ArcBotics/Sparki/Lessons/SparkiDuino/mazeSolving/Sparki.Poster.Maze1.90x70.png

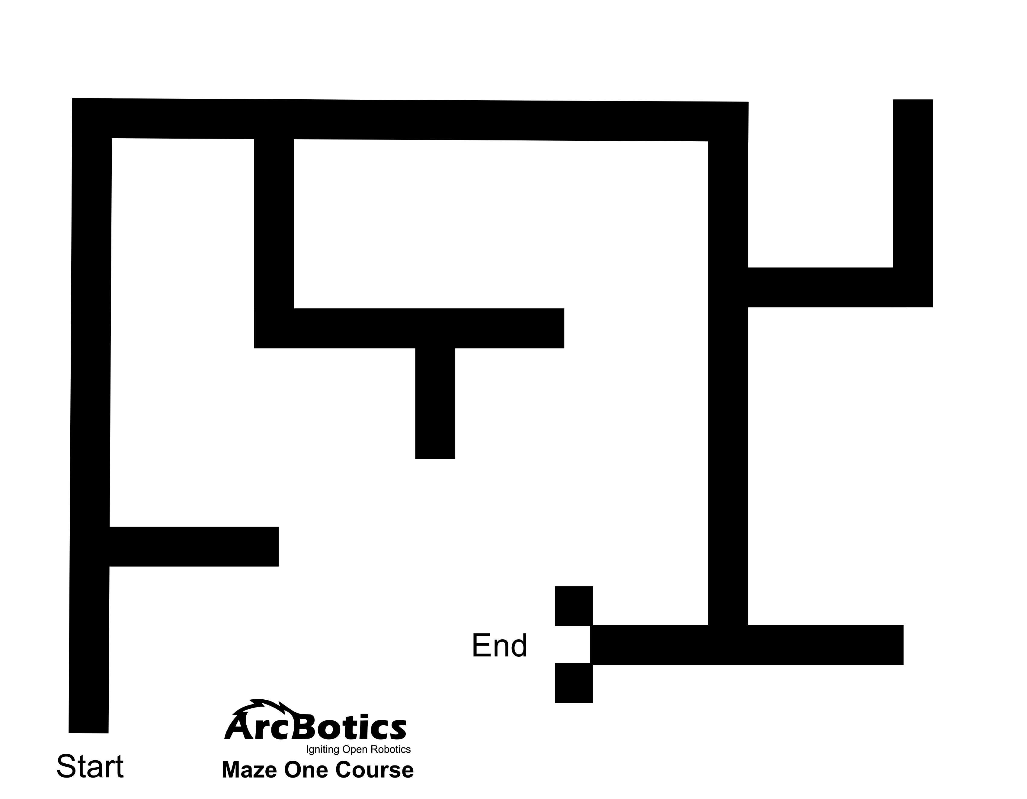
Lessons/SparkiDuino/mazeSolving/Sparki.Poster.Maze1.90x70.png
