ArcBotics/Sparki/3D Model/Full Robot.SLDASM

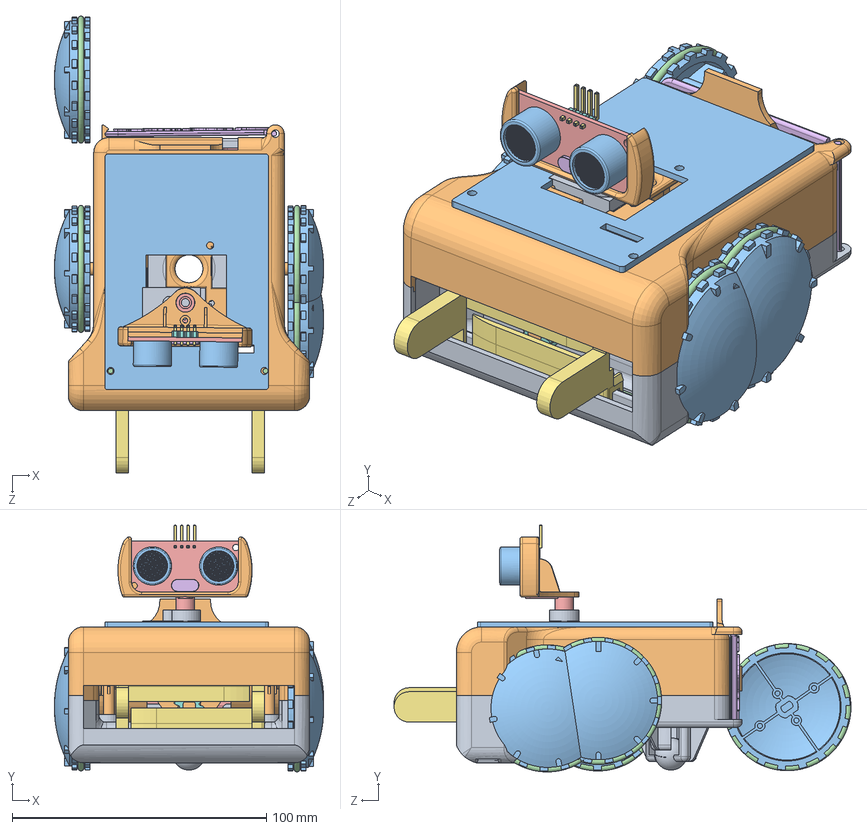
[picture p2: CAD file, 2013-09-03]
3D Model/Full Robot.SLDASM
106.0 x 97.1 x 179.8 mm
Bottom
28BYJ48 Stepper Motor x 3
Wheel x 4
ORing x 4
2xAA Battery Holder x 2
AA Battery x 4
Hand x 2
Gear
0.5in Ball Bearing
Head
Metal_Cone x 2
Grid x 2
HC-SR04_Circuit Board
Crystal
HeaderPinRightAngle x 4
HeaderBody x 4
Servo
Top
Board
Sensor Board
Servo Arm Short
Door
