ArcBotics/Sparki/3D Model/HC-SR04/Sense Cone.SLDASM

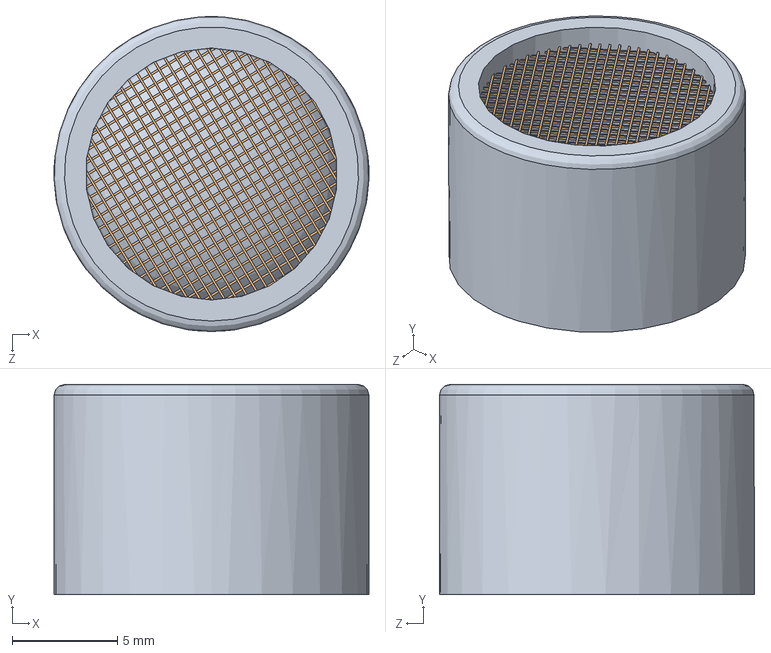
[picture p3: CAD file, 2013-05-01]
3D Model/HC-SR04/Sense Cone.SLDASM
15.0 x 10.0 x 15.0 mm
Metal_Cone
Grid
