ArcBotics/Sparki/3D Model/Injection Molded Plastic/Wheel/Wheel with Ring.SLDASM

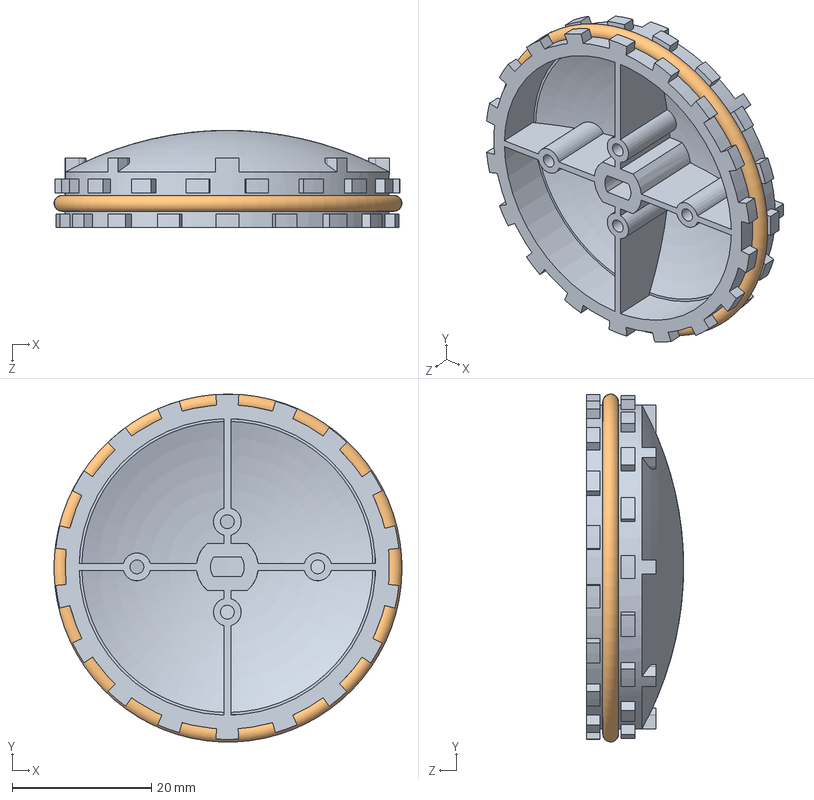
[picture p4: CAD file, 2013-09-03]
3D Model/Injection Molded Plastic/Wheel/Wheel with Ring.SLDASM
50.0 x 50.0 x 14.0 mm
Wheel
ORing
