ArcBotics/Sparki/3D Model/Battery Pack/4xAA Battery Holder.SLDASM

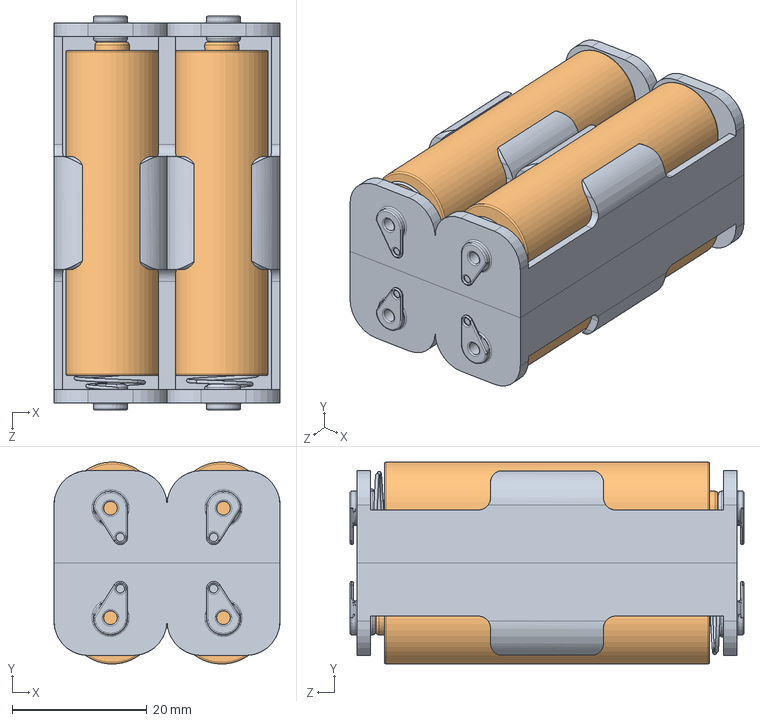
[picture p5: CAD file, 2013-05-01]
3D Model/Battery Pack/4xAA Battery Holder.SLDASM
33.5 x 29.9 x 58.4 mm
2xAA Battery Holder x 2
AA Battery x 4
