ArcBotics/Sparki/3D Model/HC-SR04/HeaderPins_4x1.SLDASM

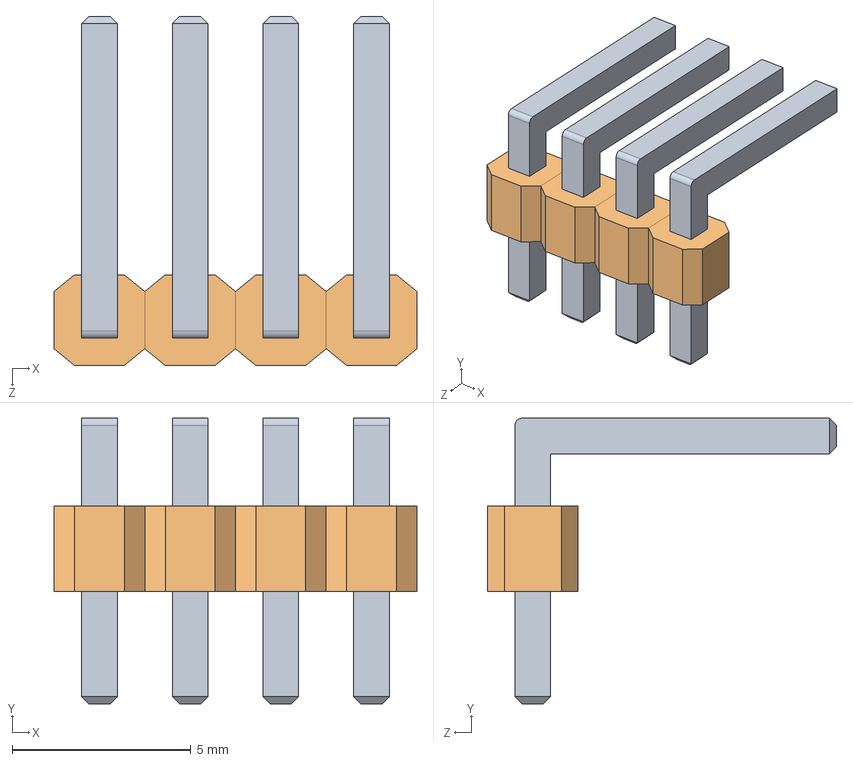
[picture p6: CAD file, 2013-05-01]
3D Model/HC-SR04/HeaderPins_4x1.SLDASM
10.2 x 8.00 x 9.77 mm
HeaderPinRightAngle x 4
HeaderBody x 4
