ArcBotics/Sparki/3D Model/HC-SR04/HC-SR04.SLDASM

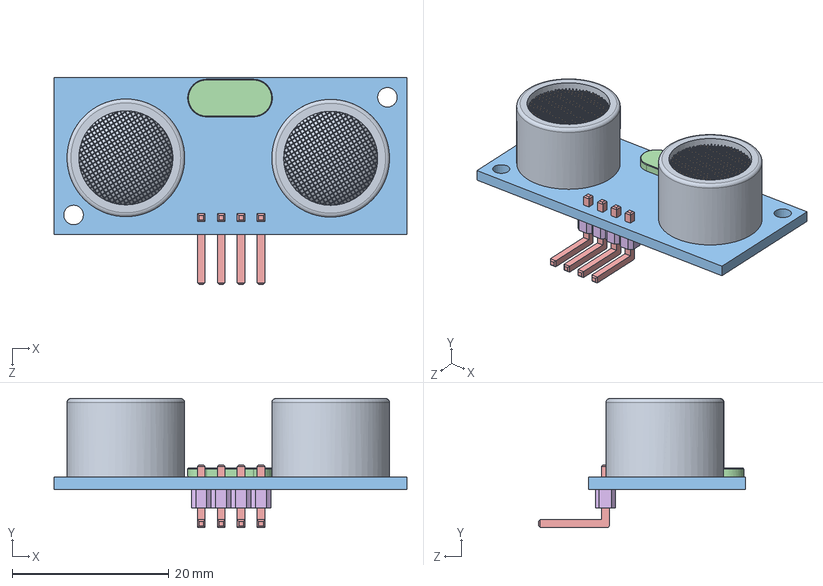
[picture p7: CAD file, 2013-05-01]
3D Model/HC-SR04/HC-SR04.SLDASM
45.0 x 16.5 x 26.3 mm
Metal_Cone x 2
Grid x 2
HC-SR04_Circuit Board
Crystal
HeaderPinRightAngle x 4
HeaderBody x 4
