ArcBotics/Sparki/3D Model/Battery Pack/AA Battery.SLDPRT

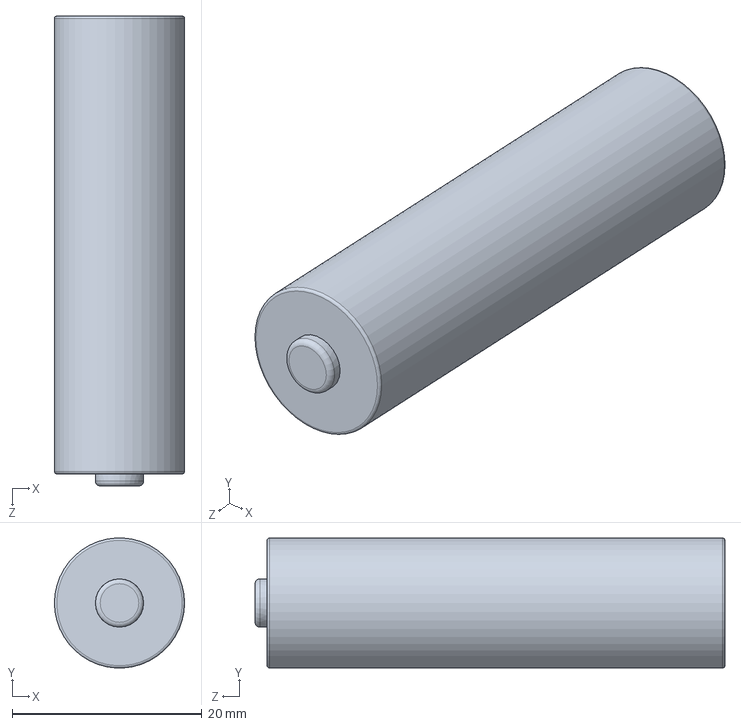
[picture p8: CAD file, 2013-05-01]
3D Model/Battery Pack/AA Battery.SLDPRT
13.7 x 13.7 x 49.5 mm
