ArcBotics/Sparki/3D Model/Injection Molded Plastic/Head.SLDPRT

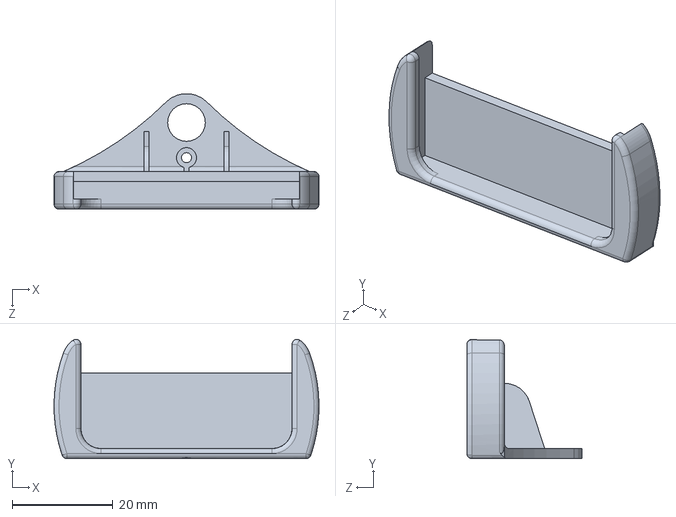
[picture p9: CAD file, 2013-09-03]
3D Model/Injection Molded Plastic/Head.SLDPRT
52.7 x 23.7 x 23.0 mm
