ArcBotics/Sparki/3D Model/Injection Molded Plastic/STEP/Gear.STEP

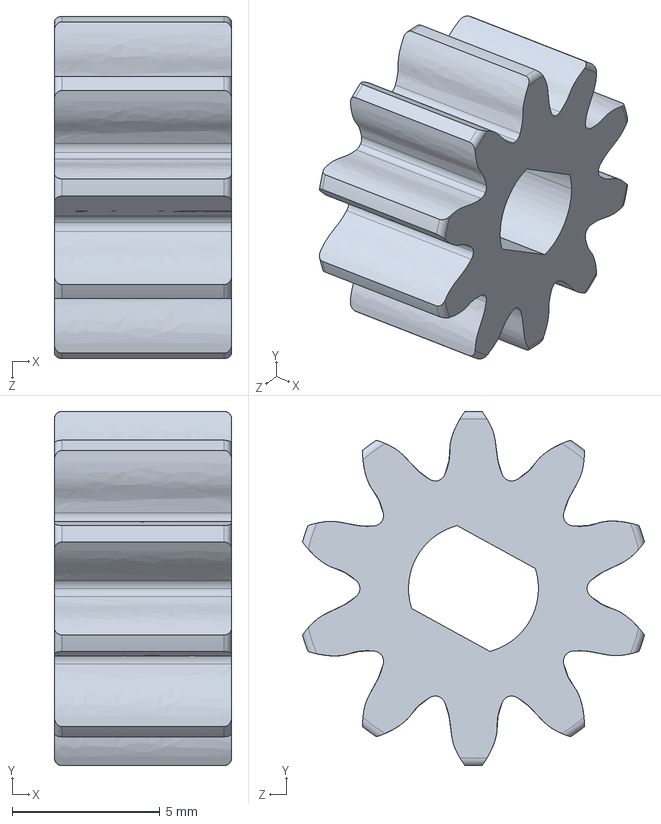
[picture p10: CAD file, 2013-09-03]
3D Model/Injection Molded Plastic/STEP/Gear.STEP
6.00 x 12.0 x 11.6 mm
