ArcBotics/Sparki/3D Model/Servo/Servo.SLDPRT

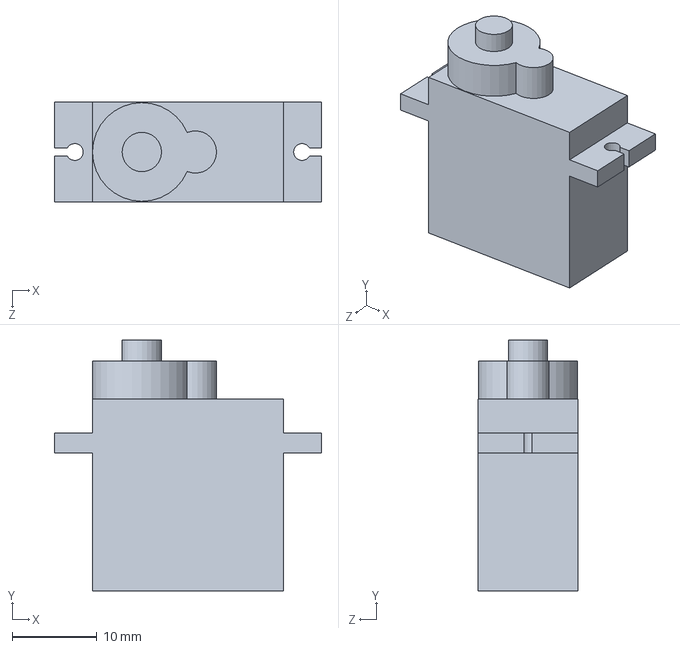
[picture p11: CAD file, 2013-05-01]
3D Model/Servo/Servo.SLDPRT
31.6 x 29.7 x 11.8 mm
