ArcBotics/Sparki/3D Model/Battery Pack/2xAA Battery Holder.SLDPRT

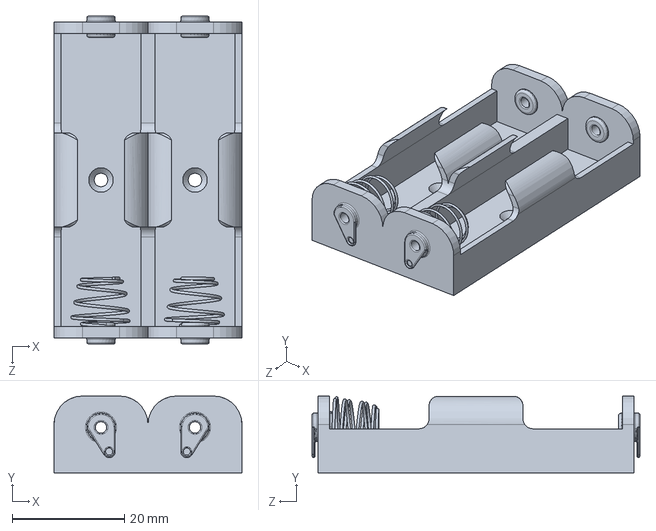
[picture p12: CAD file, 2013-05-01]
3D Model/Battery Pack/2xAA Battery Holder.SLDPRT
33.5 x 13.7 x 58.4 mm
