ArcBotics/Sparki/3D Model/HC-SR04/HeaderBody.SLDPRT

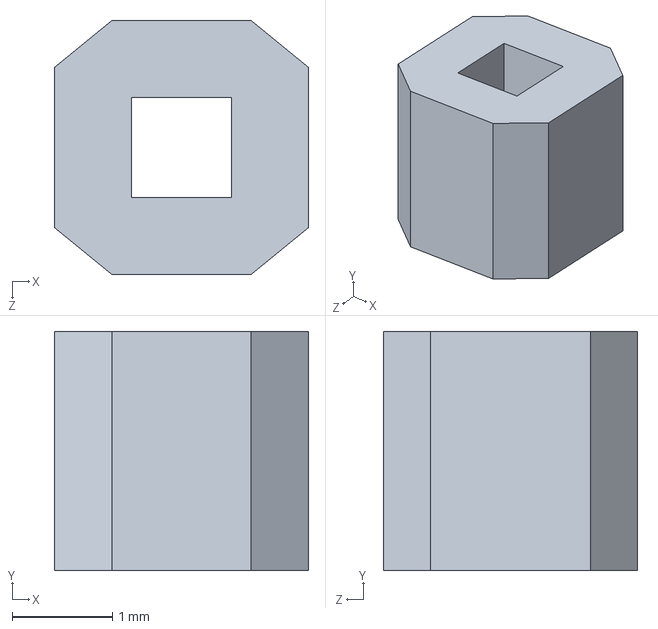
[picture p13: CAD file, 2013-05-01]
3D Model/HC-SR04/HeaderBody.SLDPRT
2.54 x 2.39 x 2.54 mm
