ArcBotics/Sparki/3D Model/Injection Molded Plastic/STEP/Bottom.STEP

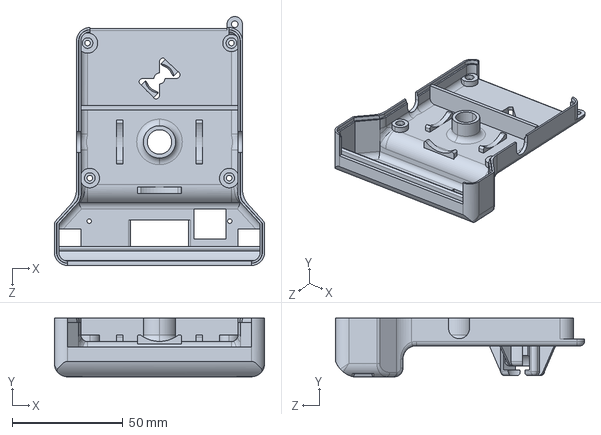
[picture p14: CAD file, 2013-09-03]
3D Model/Injection Molded Plastic/STEP/Bottom.STEP
95.0 x 26.5 x 112.5 mm
