ArcBotics/Sparki/3D Model/Injection Molded Plastic/Wheel/Wheel.SLDPRT

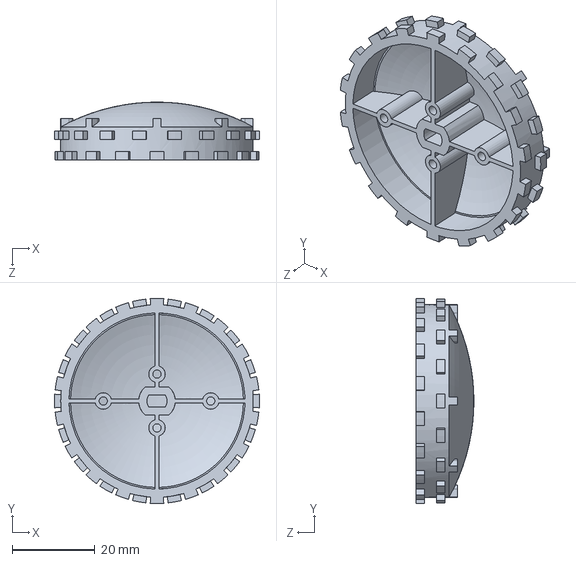
[picture p15: CAD file, 2013-09-03]
3D Model/Injection Molded Plastic/Wheel/Wheel.SLDPRT
49.6 x 49.6 x 14.0 mm
