ArcBotics/Sparki/3D Model/Sensor Board.SLDPRT

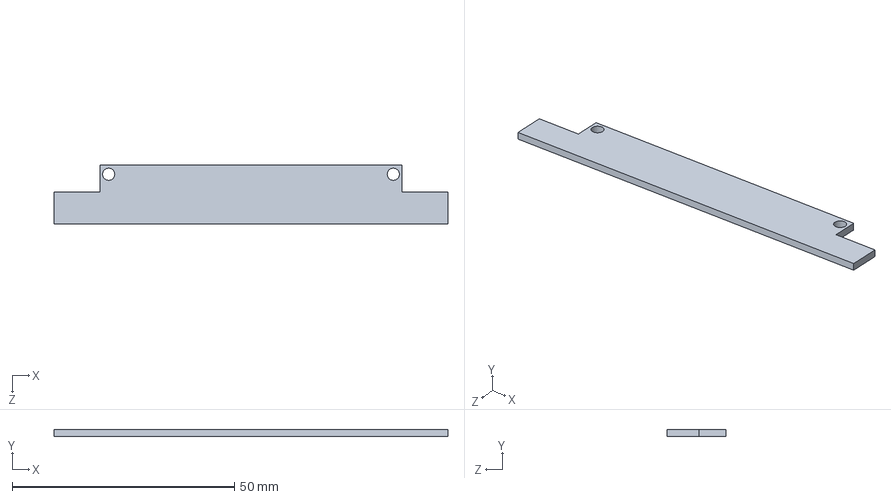
[picture p16: CAD file, 2013-09-03]
3D Model/Sensor Board.SLDPRT
88.6 x 1.60 x 13.2 mm
