ArcBotics/Sparki/3D Model/Servo/Micro Servo Horn Arm.SLDPRT

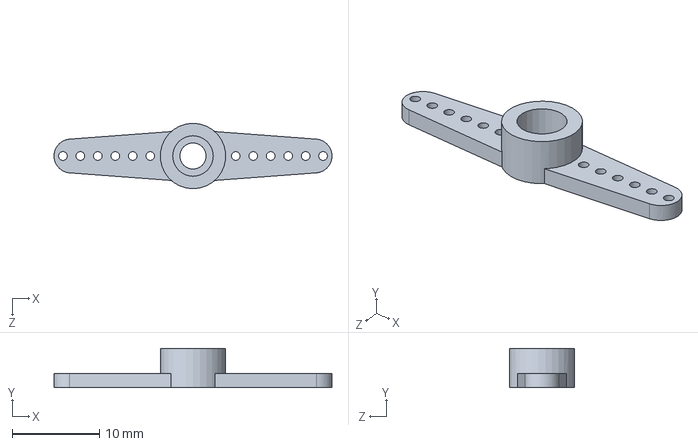
[picture p17: CAD file, 2013-05-01]
3D Model/Servo/Micro Servo Horn Arm.SLDPRT
31.8 x 4.50 x 7.50 mm
