ArcBotics/Sparki/3D Model/0.5in Ball Bearing.SLDPRT

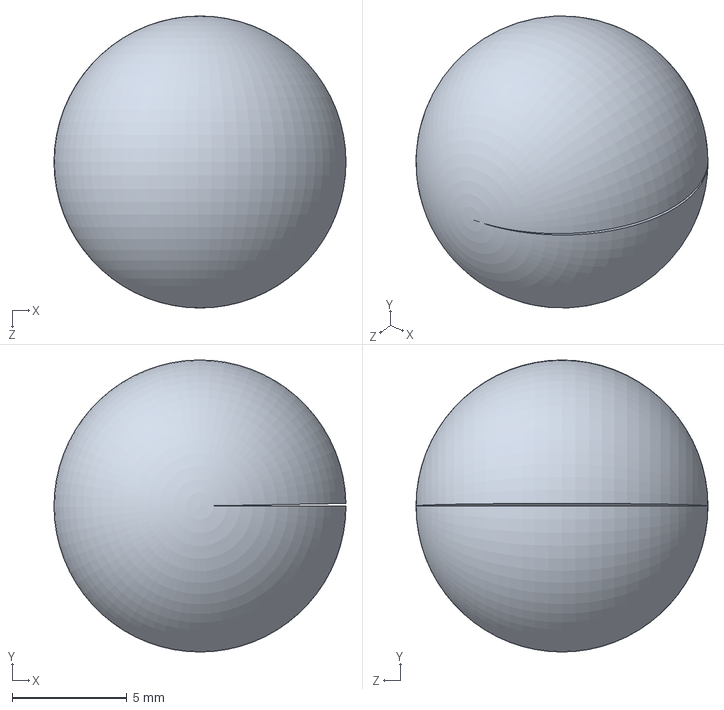
[picture p18: CAD file, 2013-05-01]
3D Model/0.5in Ball Bearing.SLDPRT
12.7 x 12.7 x 12.7 mm
