ArcBotics/Sparki/3D Model/HC-SR04/Metal_Cone.SLDPRT

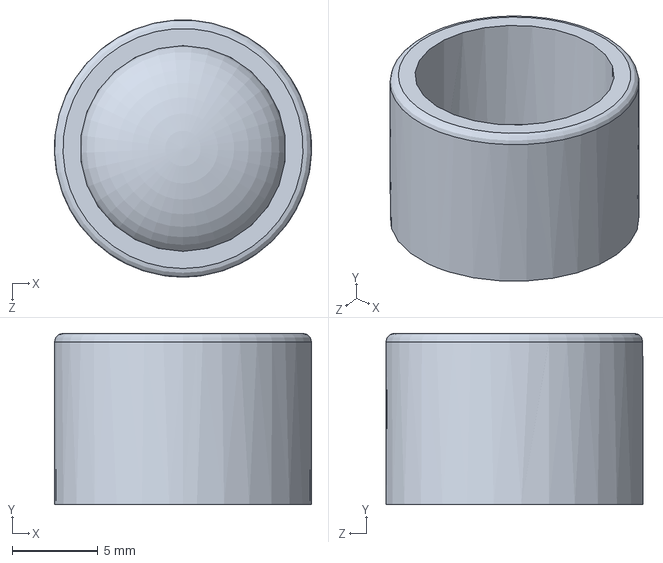
[picture p19: CAD file, 2013-05-01]
3D Model/HC-SR04/Metal_Cone.SLDPRT
15.0 x 10.0 x 15.0 mm
