ArcBotics/Sparki/3D Model/Injection Molded Plastic/STEP/Top.STEP

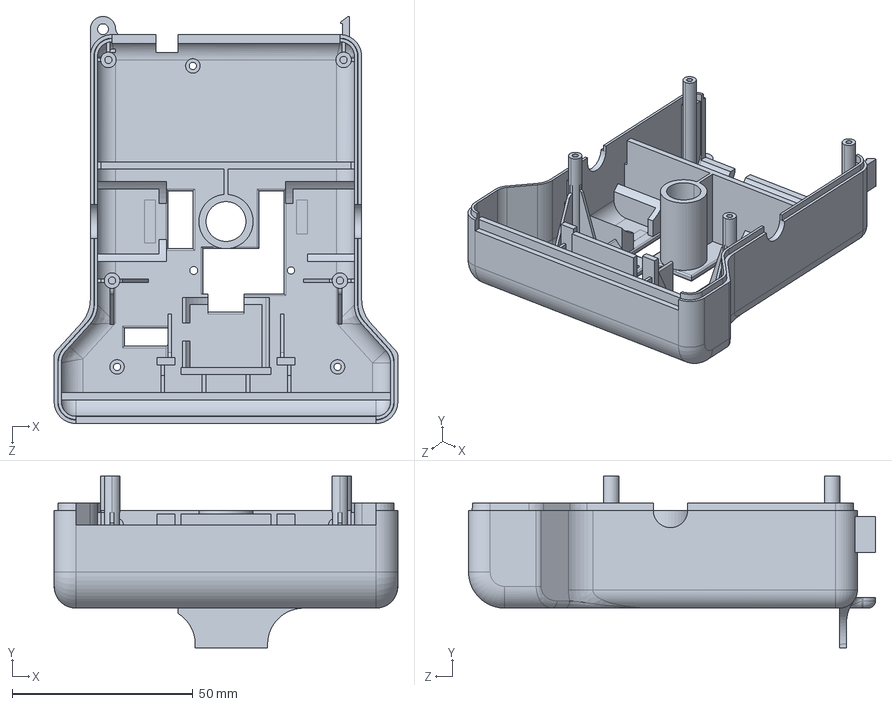
[picture p20: CAD file, 2013-09-03]
3D Model/Injection Molded Plastic/STEP/Top.STEP
95.0 x 47.5 x 112.5 mm
