ArcBotics/Sparki/3D Model/Injection Molded Plastic/Wheel/ORing.SLDPRT

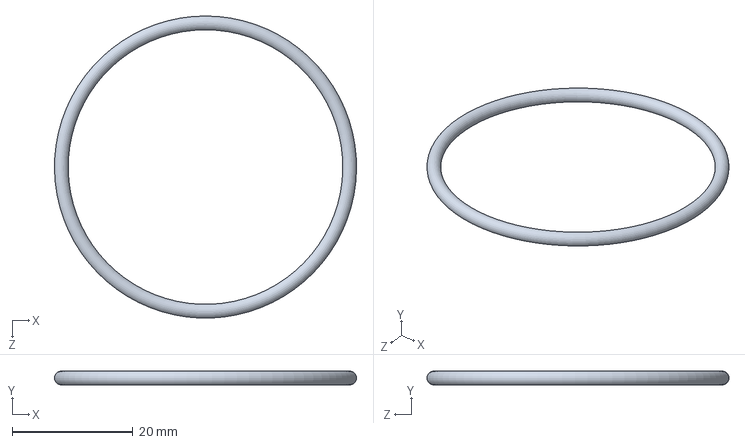
[picture p21: CAD file, 2013-05-01]
3D Model/Injection Molded Plastic/Wheel/ORing.SLDPRT
50.0 x 2.29 x 50.0 mm
