ArcBotics/Sparki/3D Model/Board Rev7.SLDPRT

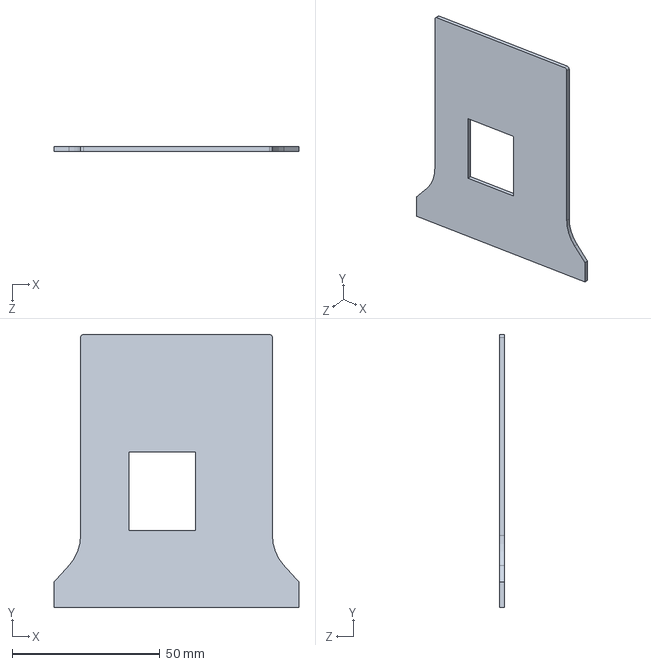
[picture p22: CAD file, 2013-05-01]
3D Model/Board Rev7.SLDPRT
83.0 x 92.5 x 1.60 mm
