ArcBotics/Sparki/3D Model/HC-SR04/HeaderPinRightAngle.SLDPRT

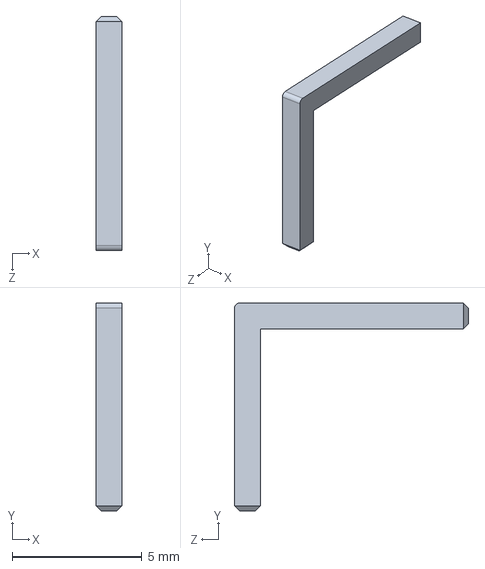
[picture p23: CAD file, 2013-05-01]
3D Model/HC-SR04/HeaderPinRightAngle.SLDPRT
1.00 x 8.00 x 9.00 mm
