ArcBotics/Sparki/3D Model/Injection Molded Plastic/STEP/Hand.STEP

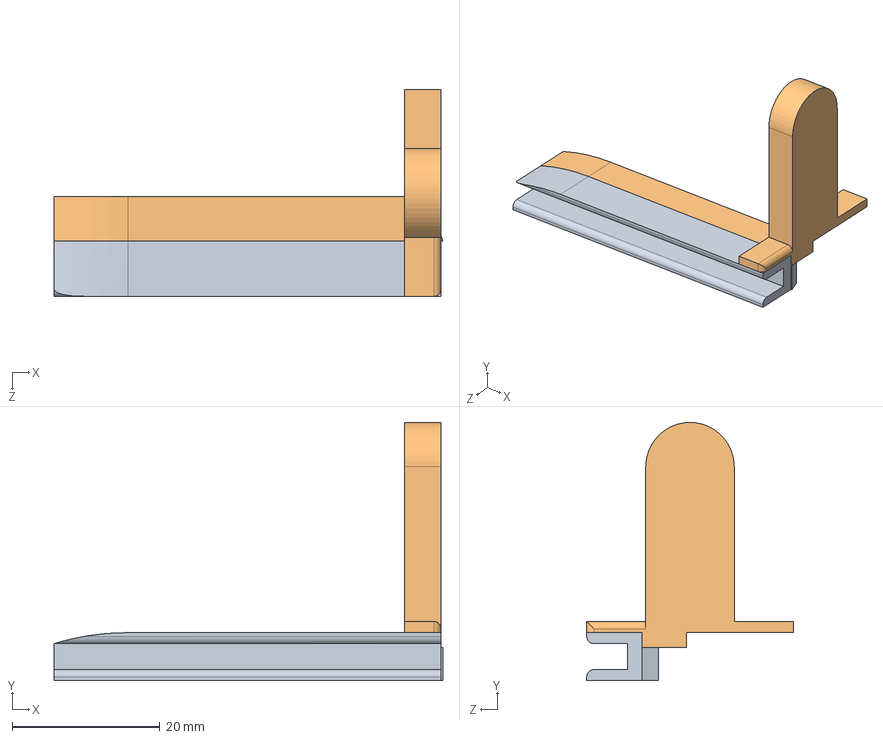
[picture p24: CAD file, 2013-09-03]
3D Model/Injection Molded Plastic/STEP/Hand.STEP
52.7 x 35.0 x 28.0 mm
