ArcBotics/Sparki/3D Model/Injection Molded Plastic/STEP/Door.STEP

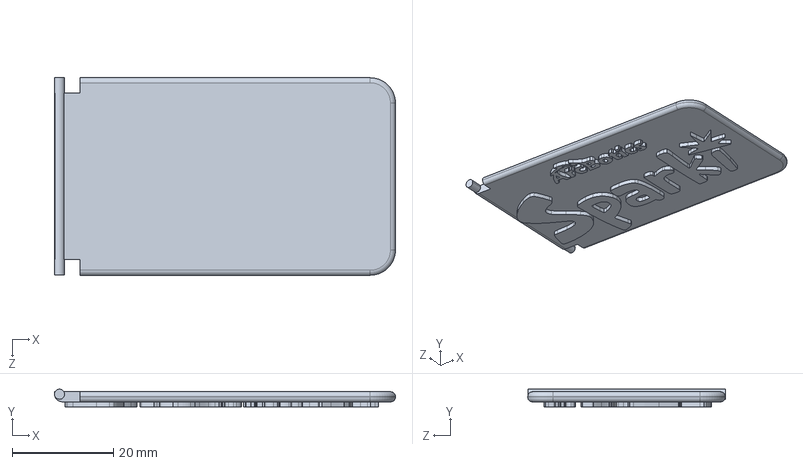
[picture p25: CAD file, 2013-09-03]
3D Model/Injection Molded Plastic/STEP/Door.STEP
67.5 x 3.50 x 39.1 mm
