ArcBotics/Sparki/3D Model/Remote.SLDPRT

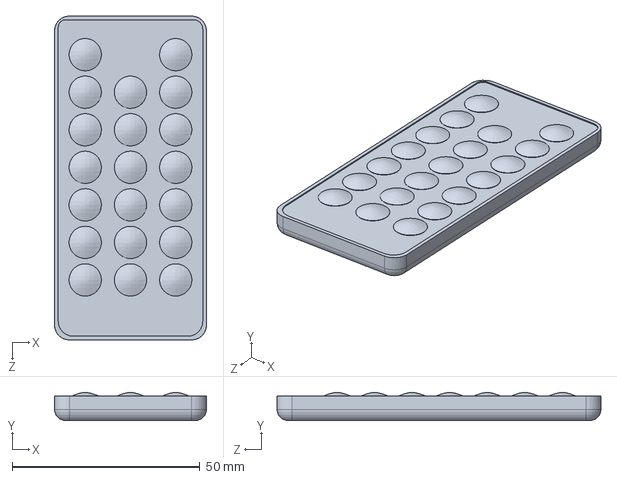
[picture p26: CAD file, 2013-05-01]
3D Model/Remote.SLDPRT
40.5 x 7.50 x 86.3 mm
