ArcBotics/Sparki/3D Model/28BYJ48 Stepper Motor.SLDPRT

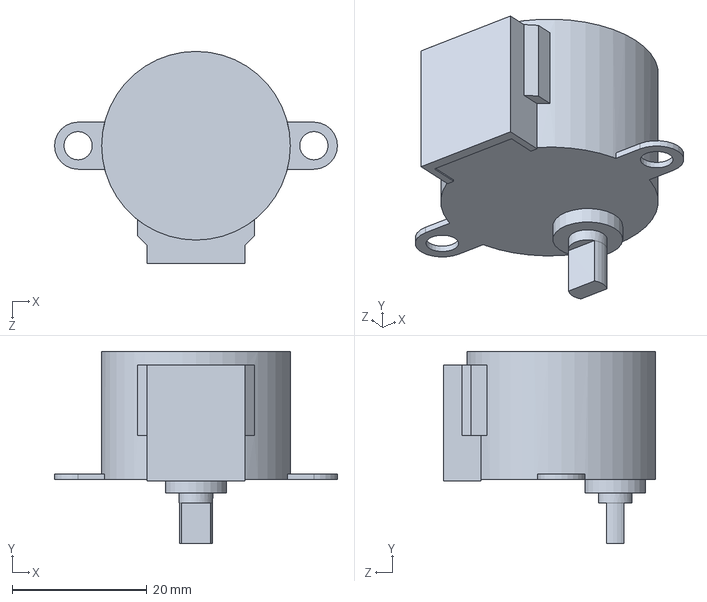
[picture p27: CAD file, 2013-05-01]
3D Model/28BYJ48 Stepper Motor.SLDPRT
42.0 x 28.5 x 31.5 mm
