ArcBotics/Sparki/3D Model/HC-SR04/Grid.SLDPRT

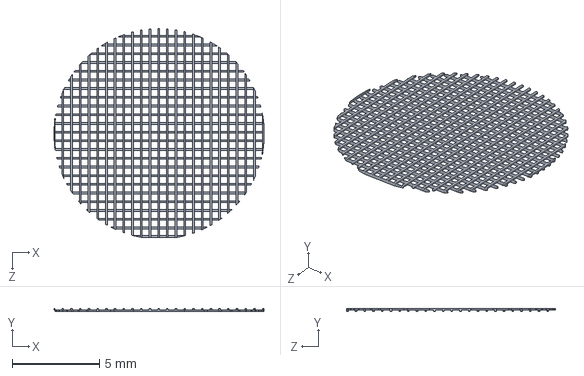
[picture p28: CAD file, 2013-05-01]
3D Model/HC-SR04/Grid.SLDPRT
12.1 x 0.2 x 12.0 mm
