ArcBotics/Sparki/3D Model/HC-SR04/HC-SR04_Circuit Board.SLDPRT

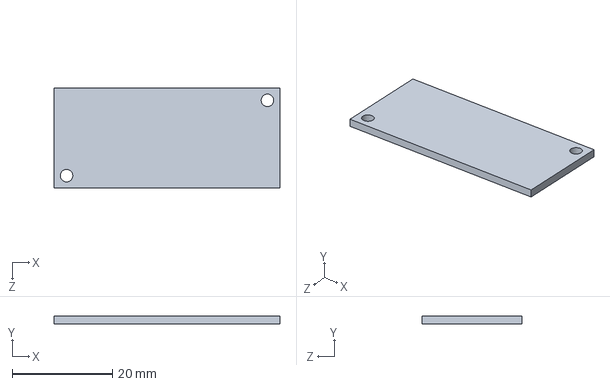
[picture p29: CAD file, 2013-05-01]
3D Model/HC-SR04/HC-SR04_Circuit Board.SLDPRT
45.0 x 1.60 x 20.0 mm
