ArcBotics/Sparki/3D Model/HC-SR04/Crystal.SLDPRT

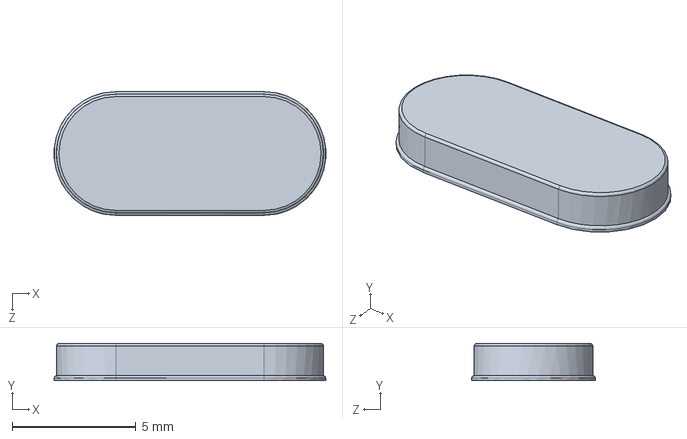
[picture p30: CAD file, 2013-05-01]
3D Model/HC-SR04/Crystal.SLDPRT
11.0 x 1.50 x 5.00 mm
