ArcBotics/Sparki/(list of files, cad)

Other CAD files:
3D Model/Injection Molded Plastic/STEP/Wheel.STEP
3D Model/Injection Molded Plastic/Door.SLDPRT
3D Model/Injection Molded Plastic/Gear.SLDPRT
3D Model/Injection Molded Plastic/Hand.SLDPRT
3D Model/Injection Molded Plastic/IGES/Bottom.IGS
3D Model/Injection Molded Plastic/IGES/Door.IGS
3D Model/Injection Molded Plastic/IGES/Gear.IGS
3D Model/Injection Molded Plastic/IGES/Hand.IGS
3D Model/Injection Molded Plastic/IGES/Head.IGS
3D Model/Injection Molded Plastic/IGES/Top.IGS
3D Model/Injection Molded Plastic/IGES/Wheel.IGS
3D Model/Injection Molded Plastic/STLs/Bottom.STL
3D Model/Injection Molded Plastic/STLs/Door.STL
3D Model/Injection Molded Plastic/STLs/Gear.STL
3D Model/Injection Molded Plastic/STLs/Hand.STL
3D Model/Injection Molded Plastic/STLs/Head.STL
3D Model/Injection Molded Plastic/STLs/Top.STL
3D Model/Injection Molded Plastic/STLs/Wheel.STL
3D Model/Injection Molded Plastic/Top.SLDPRT
3D Model/Servo/Micro Servo Horn Arm.STL
3D Model/Servo/Servo.STL
