ArcBotics/Sparki/(threads)

Thread 9 (2017-12-14):

Cannot compile any example

halflings, 2017-12-14:
This might be the wrong repo for this issue, but I cannot compile any code and upload it to my Sparki. I get this error in Sparkiduino (running in Mac OS HIgh Sierra):

```
Arduino: 1.6.9 (Mac OS X), Board: "ArcBotics Sparki"

failed MSpanList_Insert 0x30c000 0x25777cc21c79 0x0
fatal error: MSpanList_Insert

runtime stack:
runtime.throw(0x2ac50b)
	/usr/local/go/src/runtime/panic.go:491 +0xad fp=0x7ffeefbff4a0 sp=0x7ffeefbff470
runtime.MSpanList_Insert(0x2ca128, 0x30c000)
	/usr/local/go/src/runtime/mheap.c:692 +0x8f fp=0x7ffeefbff4c8 sp=0x7ffeefbff4a0
MHeap_FreeSpanLocked(0x2c6d20, 0x30c000, 0x100)
	/usr/local/go/src/runtime/mheap.c:583 +0x163 fp=0x7ffeefbff508 sp=0x7ffeefbff4c8
MHeap_Grow(0x2c6d20, 0x8, 0x0)
	/usr/local/go/src/runtime/mheap.c:420 +0x1a8 fp=0x7ffeefbff548 sp=0x7ffeefbff508
MHeap_AllocSpanLocked(0x2c6d20, 0x1, 0x0)
	/usr/local/go/src/runtime/mheap.c:298 +0x365 fp=0x7ffeefbff588 sp=0x7ffeefbff548
mheap_alloc(0x2c6d20, 0x1, 0x12, 0x0)
	/usr/local/go/src/runtime/mheap.c:190 +0x121 fp=0x7ffeefbff5b0 sp=0x7ffeefbff588
runtime.MHeap_Alloc(0x2c6d20, 0x1, 0x10000000012, 0xf989)
	/usr/local/go/src/runtime/mheap.c:240 +0x66 fp=0x7ffeefbff5e8 sp=0x7ffeefbff5b0
MCentral_Grow(0x2cea98, 0x0)
	/usr/local/go/src/runtime/mcentral.c:197 +0x8b fp=0x7ffeefbff650 sp=0x7ffeefbff5e8
runtime.MCentral_CacheSpan(0x2cea98, 0x0)
	/usr/local/go/src/runtime/mcentral.c:85 +0x167 fp=0x7ffeefbff688 sp=0x7ffeefbff650
runtime.MCache_Refill(0x308000, 0x12, 0x0)
	/usr/local/go/src/runtime/mcache.c:90 +0xa0 fp=0x7ffeefbff6b0 sp=0x7ffeefbff688
runtime.mcacheRefill_m()
	/usr/local/go/src/runtime/malloc.c:368 +0x57 fp=0x7ffeefbff6d0 sp=0x7ffeefbff6b0
runtime.onM(0x223ad0)
	/usr/local/go/src/runtime/asm_amd64.s:273 +0x9a fp=0x7ffeefbff6d8 sp=0x7ffeefbff6d0
runtime.mallocgc(0x120, 0x1bde40, 0x0, 0x0)
	/usr/local/go/src/runtime/malloc.go:178 +0x849 fp=0x7ffeefbff788 sp=0x7ffeefbff6d8
runtime.newobject(0x1bde40, 0x308000)
	/usr/local/go/src/runtime/malloc.go:353 +0x49 fp=0x7ffeefbff7b0 sp=0x7ffeefbff788
runtime.newG(0x276ba)
	/usr/local/go/src/runtime/proc.go:233 +0x2a fp=0x7ffeefbff7c8 sp=0x7ffeefbff7b0
allocg(0x2b9660)
	/usr/local/go/src/runtime/proc.c:925 +0x1f fp=0x7ffeefbff7d8 sp=0x7ffeefbff7c8
runtime.malg(0x8000, 0x2b9700)
	/usr/local/go/src/runtime/proc.c:2106 +0x1f fp=0x7ffeefbff808 sp=0x7ffeefbff7d8
runtime.mpreinit(0x2b9ac0)
	/usr/local/go/src/runtime/os_darwin.c:137 +0x27 fp=0x7ffeefbff820 sp=0x7ffeefbff808
mcommoninit(0x2b9ac0)
	/usr/local/go/src/runtime/proc.c:201 +0xc9 fp=0x7ffeefbff848 sp=0x7ffeefbff820
runtime.schedinit()
	/usr/local/go/src/runtime/proc.c:138 +0x55 fp=0x7ffeefbff870 sp=0x7ffeefbff848
runtime.rt0_go(0x7ffeefbff8a0, 0x14, 0x7ffeefbff8a0, 0x0, 0x14, 0x7ffeefbffa50, 0x7ffeefbffa8c, 0x7ffeefbffa98, 0x7ffeefbffaa8, 0x7ffeefbffab2, ...)
	/usr/local/go/src/runtime/asm_amd64.s:95 +0x116 fp=0x7ffeefbff878 sp=0x7ffeefbff870
arduino-builder returned 2

Error compiling for board ArcBotics Sparki.

This report would have more information with
"Show verbose output during compilation"
option enabled in File -> Preferences.
```

halflings, 2017-12-14:
And after enabling verbose output:

```
Arduino: 1.6.9 (Mac OS X), Board: "ArcBotics Sparki"

/Applications/SparkiDuino.app/Contents/Java/arduino-builder -dump-prefs -logger=machine -hardware "/Applications/SparkiDuino.app/Contents/Java/hardware" -tools "/Applications/SparkiDuino.app/Contents/Java/tools-builder" -tools "/Applications/SparkiDuino.app/Contents/Java/hardware/tools/avr" -built-in-libraries "/Applications/SparkiDuino.app/Contents/Java/libraries" -libraries "/Users/kachkach/Documents/Arduino/libraries" -fqbn=arduino:avr:sparki -ide-version=10609 -build-path "/var/folders/xw/ch07jry12bn15s2bhs2wlvr40000gn/T/build3a41f3b425e83c77f8d8f339388199db.tmp" -warnings=none -prefs=build.warn_data_percentage=75 -verbose "/Applications/SparkiDuino.app/Contents/Java/examples/Melody/Melody.ino"
failed MSpanList_Insert 0x30c000 0x259d21c62452 0x0
fatal error: MSpanList_Insert

runtime stack:
runtime.throw(0x2ac50b)
	/usr/local/go/src/runtime/panic.go:491 +0xad fp=0x7ffeefbff4a0 sp=0x7ffeefbff470
runtime.MSpanList_Insert(0x2ca128, 0x30c000)
	/usr/local/go/src/runtime/mheap.c:692 +0x8f fp=0x7ffeefbff4c8 sp=0x7ffeefbff4a0
MHeap_FreeSpanLocked(0x2c6d20, 0x30c000, 0x100)
	/usr/local/go/src/runtime/mheap.c:583 +0x163 fp=0x7ffeefbff508 sp=0x7ffeefbff4c8
MHeap_Grow(0x2c6d20, 0x8, 0x0)
	/usr/local/go/src/runtime/mheap.c:420 +0x1a8 fp=0x7ffeefbff548 sp=0x7ffeefbff508
MHeap_AllocSpanLocked(0x2c6d20, 0x1, 0x0)
	/usr/local/go/src/runtime/mheap.c:298 +0x365 fp=0x7ffeefbff588 sp=0x7ffeefbff548
mheap_alloc(0x2c6d20, 0x1, 0x12, 0x0)
	/usr/local/go/src/runtime/mheap.c:190 +0x121 fp=0x7ffeefbff5b0 sp=0x7ffeefbff588
runtime.MHeap_Alloc(0x2c6d20, 0x1, 0x10000000012, 0xf989)
	/usr/local/go/src/runtime/mheap.c:240 +0x66 fp=0x7ffeefbff5e8 sp=0x7ffeefbff5b0
MCentral_Grow(0x2cea98, 0x0)
	/usr/local/go/src/runtime/mcentral.c:197 +0x8b fp=0x7ffeefbff650 sp=0x7ffeefbff5e8
runtime.MCentral_CacheSpan(0x2cea98, 0x0)
	/usr/local/go/src/runtime/mcentral.c:85 +0x167 fp=0x7ffeefbff688 sp=0x7ffeefbff650
runtime.MCache_Refill(0x308000, 0x12, 0x0)
	/usr/local/go/src/runtime/mcache.c:90 +0xa0 fp=0x7ffeefbff6b0 sp=0x7ffeefbff688
runtime.mcacheRefill_m()
	/usr/local/go/src/runtime/malloc.c:368 +0x57 fp=0x7ffeefbff6d0 sp=0x7ffeefbff6b0
runtime.onM(0x223ad0)
	/usr/local/go/src/runtime/asm_amd64.s:273 +0x9a fp=0x7ffeefbff6d8 sp=0x7ffeefbff6d0
runtime.mallocgc(0x120, 0x1bde40, 0x0, 0x0)
	/usr/local/go/src/runtime/malloc.go:178 +0x849 fp=0x7ffeefbff788 sp=0x7ffeefbff6d8
runtime.newobject(0x1bde40, 0x308000)
	/usr/local/go/src/runtime/malloc.go:353 +0x49 fp=0x7ffeefbff7b0 sp=0x7ffeefbff788
runtime.newG(0x276ba)
	/usr/local/go/src/runtime/proc.go:233 +0x2a fp=0x7ffeefbff7c8 sp=0x7ffeefbff7b0
allocg(0x2b9660)
	/usr/local/go/src/runtime/proc.c:925 +0x1f fp=0x7ffeefbff7d8 sp=0x7ffeefbff7c8
runtime.malg(0x8000, 0x2b9700)
	/usr/local/go/src/runtime/proc.c:2106 +0x1f fp=0x7ffeefbff808 sp=0x7ffeefbff7d8
runtime.mpreinit(0x2b9ac0)
	/usr/local/go/src/runtime/os_darwin.c:137 +0x27 fp=0x7ffeefbff820 sp=0x7ffeefbff808
mcommoninit(0x2b9ac0)
	/usr/local/go/src/runtime/proc.c:201 +0xc9 fp=0x7ffeefbff848 sp=0x7ffeefbff820
runtime.schedinit()
	/usr/local/go/src/runtime/proc.c:138 +0x55 fp=0x7ffeefbff870 sp=0x7ffeefbff848
runtime.rt0_go(0x7ffeefbff8a0, 0x15, 0x7ffeefbff8a0, 0x0, 0x15, 0x7ffeefbffa58, 0x7ffeefbffa94, 0x7ffeefbffaa0, 0x7ffeefbffab0, 0x7ffeefbffaba, ...)
	/usr/local/go/src/runtime/asm_amd64.s:95 +0x116 fp=0x7ffeefbff878 sp=0x7ffeefbff870
arduino-builder returned 2

Error compiling for board ArcBotics Sparki.
```

halflings, 2017-12-14:
I think this might be due to a bug in the Arduino IDE version used by the Sparki version. Could you update it to the latest version?

roboalchemist, 2017-12-16:
This is an issue in how an older version of the IDE, and is specific only to OS X High Serra. Updating the latest Arduino IDE seems to fix this. We have a few other thing we're rolling into this update, and then will post a full file. In the meantime, a workaround is to use the latest Arduino IDE and add the Sparki library and board:
http://arcbotics.com/lessons/install-sparkiduino-ardublock-linux/

roboalchemist, 2017-12-24:
New install using Arduino 1.8.5 posted here, issue no longer occurs on macOS High Sierra:
http://download.arcbotics.com/SparkiDuino-OSX-1.8.5.1.zip

Closed 2017-12-24.

Thread 10 (2022-04-19):

avr-g++ keychain tool is run through a 32-bit process

rschildge, 2022-04-19:
fork/exec /Users/*******/Library/Arduino15/packages/arduino/tools/avr-gcc/4.8.1-arduino5/bin/avr-g++: bad CPU type in executable
Error compiling for board ArcBotics Sparki.

The macOS update Catalina no longer supports 32-bit applications and the avr-g++ keychain tool is run through a 32-bit process.

Is there a fix for this?
