ArcBotics/Sparki/Electronics/Sparki_Rev15.pdf

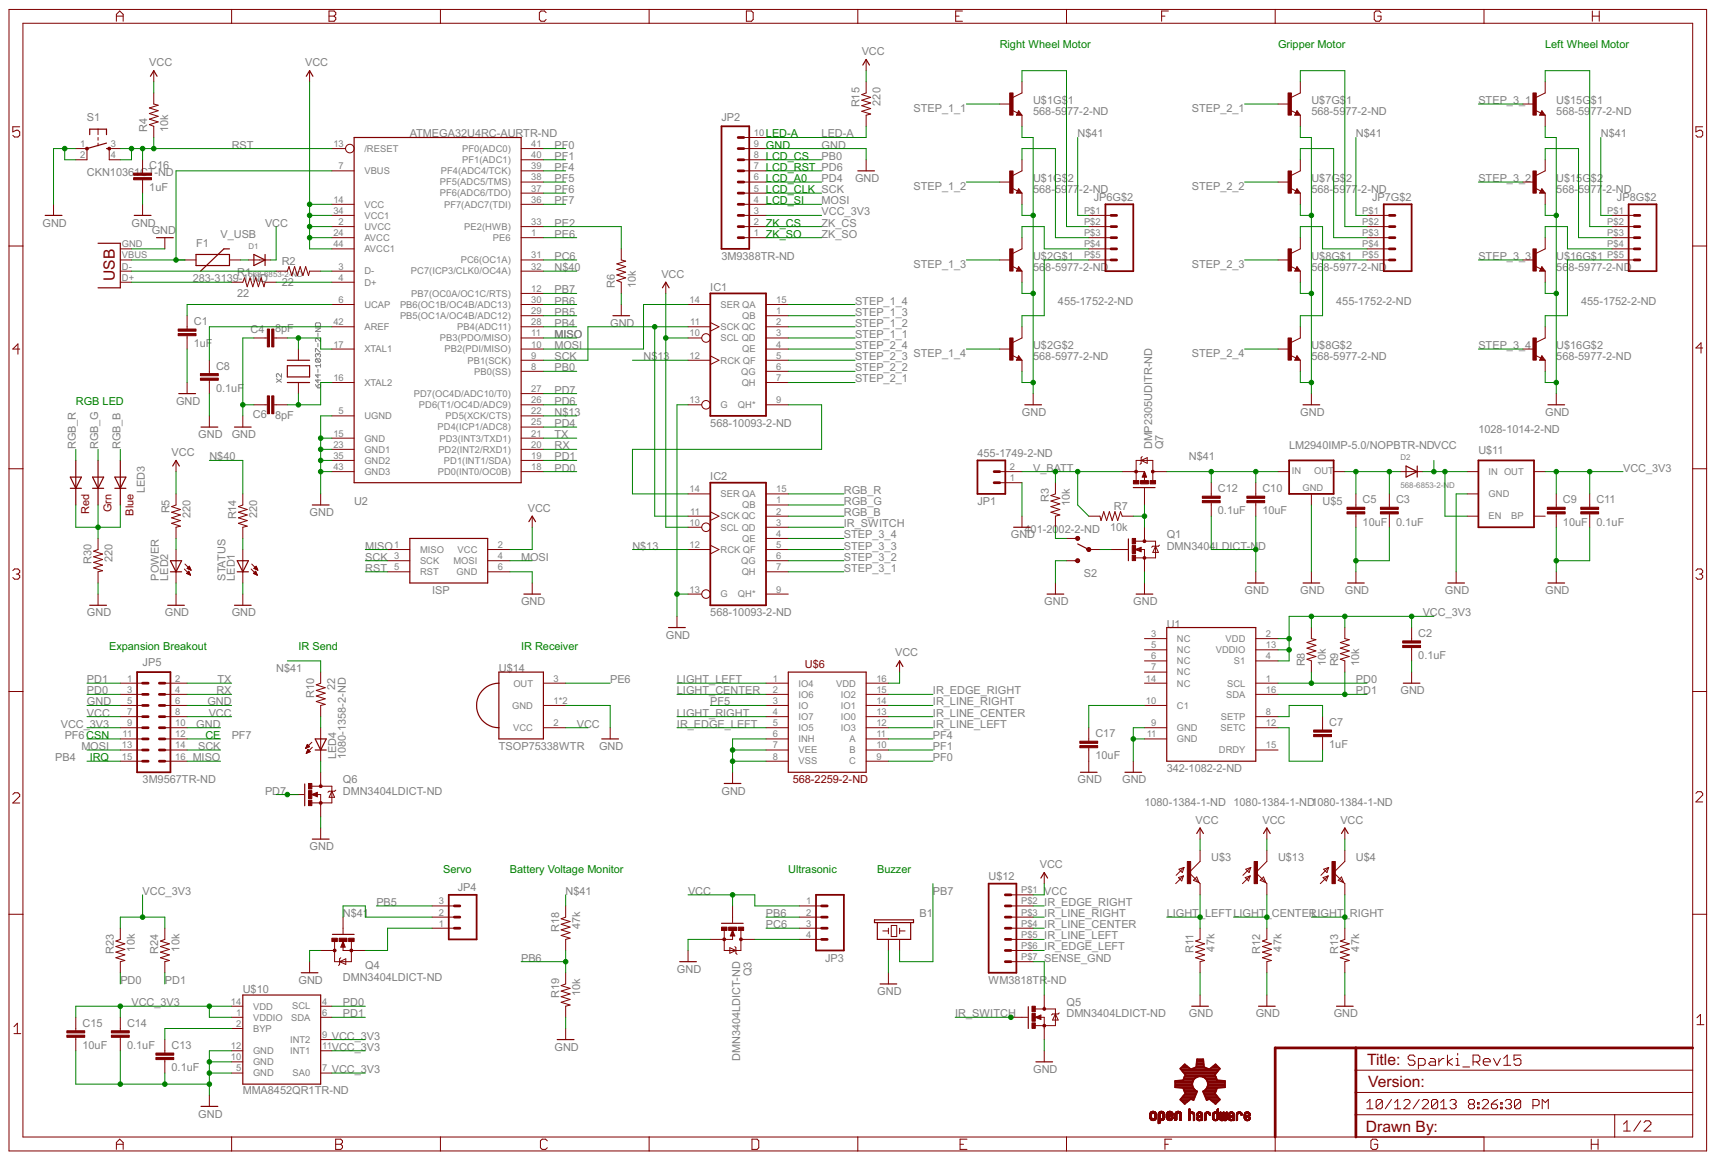
[picture p31: page 1]

Drawn By: Title: Version:

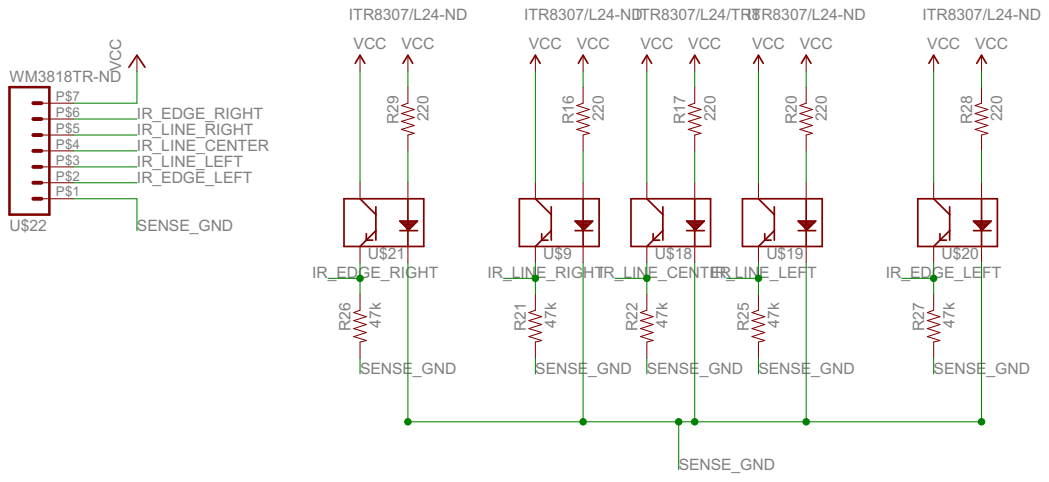
[picture p32: page 2]

220 VCC VCC VCC VCC VCC

Drawn By: Title: Version:
