ArcBotics/Sparki/Electronics/Sparki_Rev15.brd

## EAGLE design Electronics/Sparki_Rev15.brd (2014-02-04)

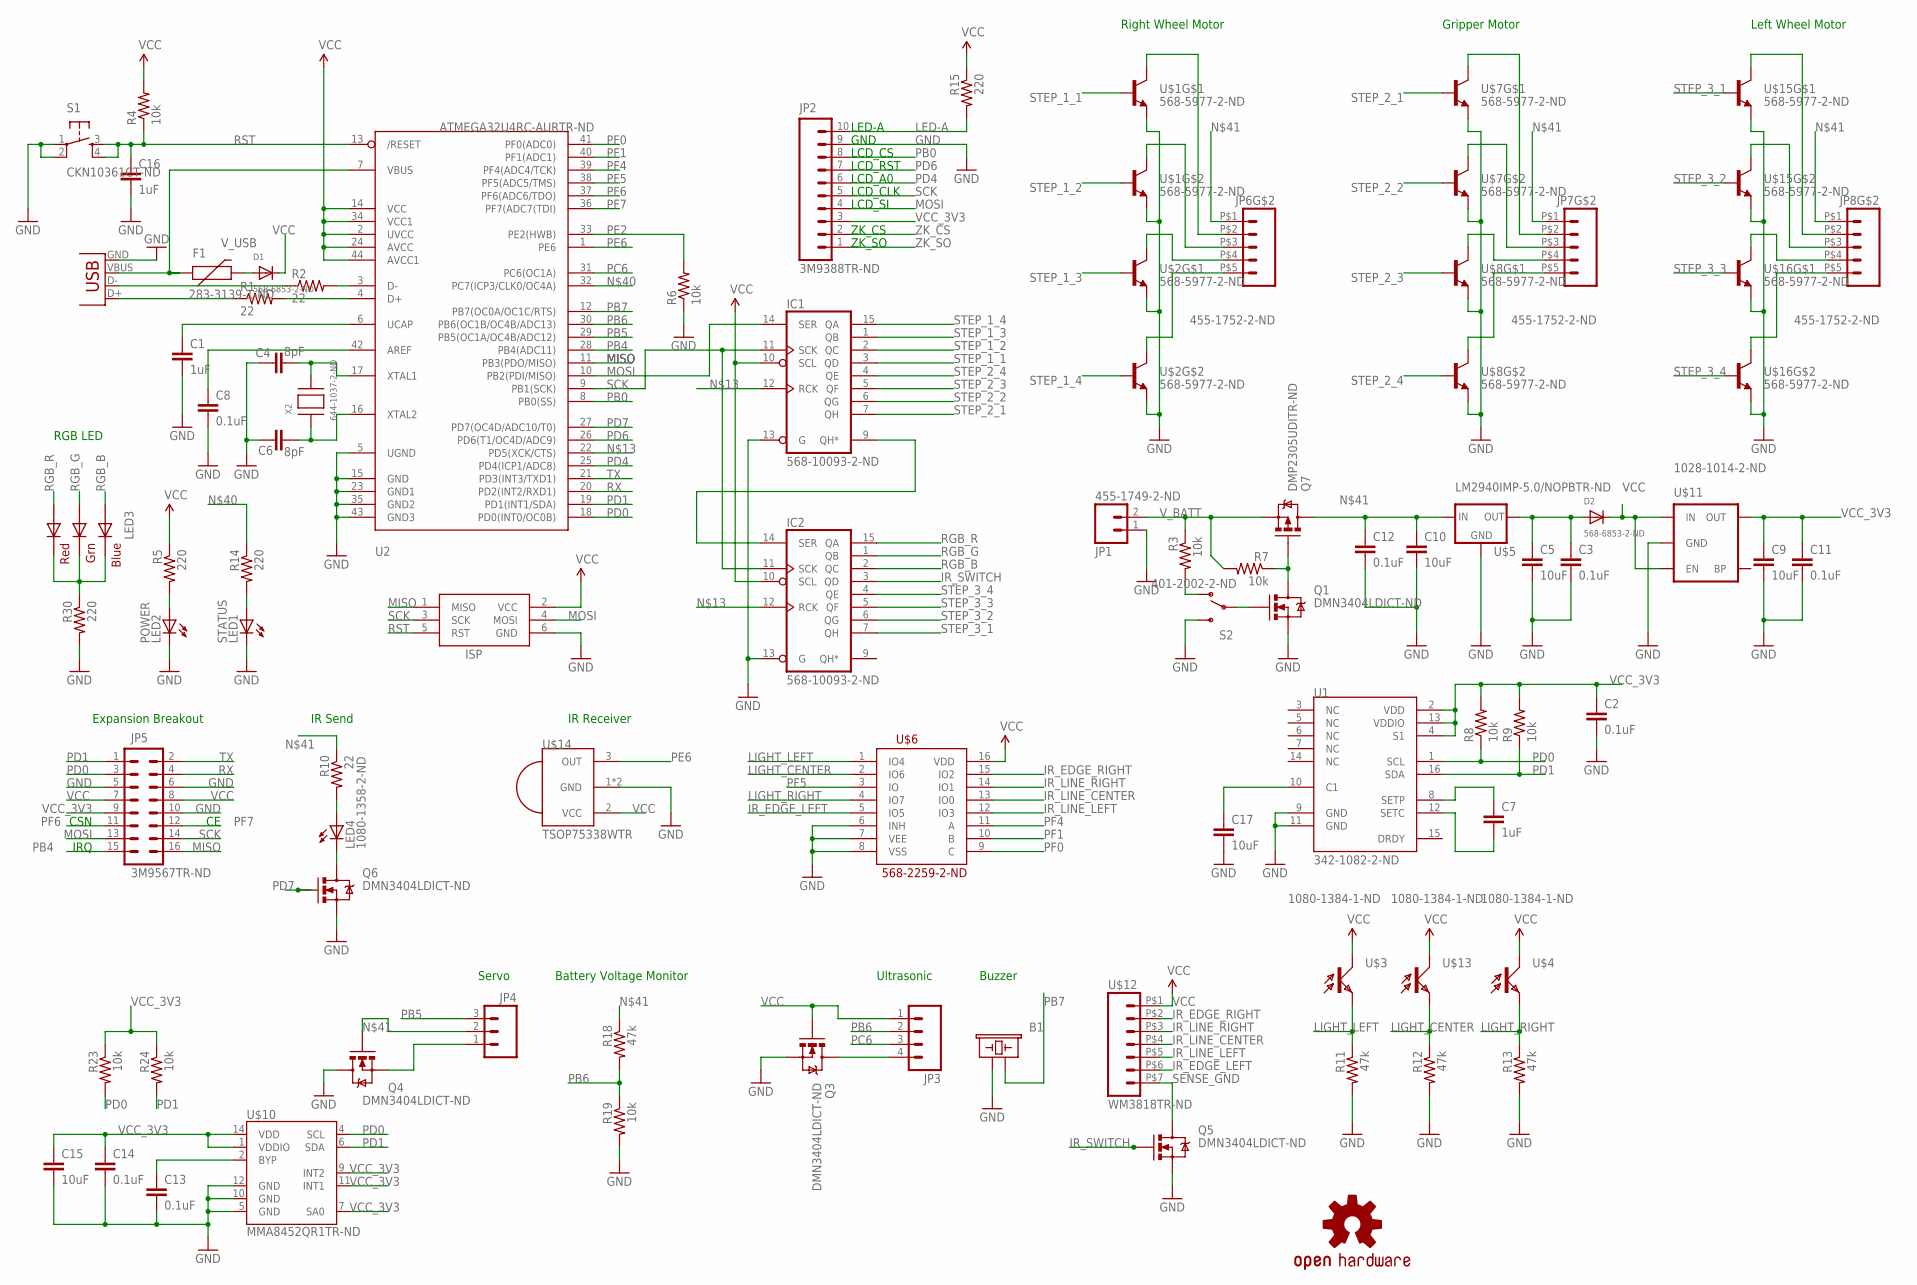
[picture p33: schematic Sparki_Rev15.sch, sheet 1]

Parts:
B1: SMT-0927-T-2-R; BUZZER-CCV
C1, C7, C16: 1uF; 0603-CAP
C2, C3, C8, C11, C12, C13, C14: 0.1uF; 0603-CAP
C4, C6: 8pF; 0603-CAP
C5, C9, C10, C15, C17: 10uF; 0805
D1, D2: 568-6853-2-ND; SOD-128
F1: 283-3139-1-ND; PTC-1206
IC1, IC2: 568-10093-2-ND; TSSOP16
ISP: AVRISP-6; AVRISP
JP1: 455-1749-2-ND; JST-2-SMD
JP2: 3M9388TR-ND; 1X10-2.54MM-SMD
JP3: 3M12031-ND; 1X04-2.54MM-SMD
JP4: M20-8900305-ND; 1X03_SMD_RA_MALE
JP5: 3M9567TR-ND; 2X08-2.54MM-SMD
JP6, JP7, JP8: 455-1752-2-ND; 1X05-2.0MM-JST-PH
LED1: STATUS; SML0805
LED2: POWER; SML0805
LED3: PLCC6RGBCT; RGBLED5050
LED4: 1080-1358-2-ND; FKIT-LED-1206
LOGO1: OSHW-LOGOM; OSHW-LOGO-M
Q1, Q3, Q4, Q5, Q6: DMN3404LDICT-ND; SOT23-3
Q7: DMP2305UDITR-ND; SOT23-3
R1, R2, R10: 22; 0603-RES
R3, R4, R6, R7, R8, R9, R19, R23, R24: 10k; 0603-RES
R5, R14, R15, R30: 220; 0603-RES
R11, R12, R13, R18: 47k; 0603-RES
S1: CKN10361CT-ND; TACTILE_SWITCH_SMD
S2: 401-2002-2-ND; AYZ0202
U1: 342-1082-2-ND; 16LPCC
U2: ATMEGA32U4RC-AURTR-ND; TQFP44
U$1, U$2, U$7, U$8, U$15, U$16: 568-5977-2-ND; SOT363
U$3, U$4, U$13: 1080-1384-1-ND; LED-0402
U$5: LM2940IMP-5.0/NOPBTR-ND; SOT223
U$6: 568-2259-2-ND; TSSOP-16
U$10: MMA8452QR1TR-ND; QFN-16_0.5MM
U$11: 1028-1014-2-ND; SOT23-5
U$12: WM3818TR-ND; 1X07-1.0MM-FPC
U$14: TSOP75338WTR; TSOP75338
X1: ED90342TR-ND; USB-MINIB
X2: 644-1037-2-ND; NX5032

Connections:
ACCEL_BYP: C13.1, U$10.2 (BYP)
D+: R1.2, U2.4 (D+)
D-: R2.2, U2.3 (D-)
GND: B1.- (2), C1.2, C2.2, C3.2, C4.2, C5.2, C6.2, C8.2, C9.2, C10.2, C11.2, C12.2, C13.2, C14.2, C15.2, C16.2, C17.2, IC1.8 (GND), IC1.13 (G), IC2.8 (GND), IC2.13 (G), ISP.6 (GND), JP1.1 (2), JP2.9, JP5.5, JP5.6, JP5.10, LED1.C, LED2.C, Q1.2 (S), Q3.2 (S), Q4.3 (D), Q5.2 (S), Q6.2 (S), R6.1, R11.2, R12.2, R13.2, R19.2, R30.2, S1.1, S1.2, S2.3 (S), U1.9 (GND), U1.11 (GND), U2.5 (UGND), U2.15 (GND), U2.23 (GND1), U2.35 (GND2), U2.43 (GND3), U$1.1 (E), U$1.4 (E), U$2.1 (E), U$2.4 (E), U$5.2 (GND), U$6.6 (INH), U$6.7 (VEE), U$6.8 (VSS), U$7.1 (E), U$7.4 (E), U$8.1 (E), U$8.4 (E), U$10.5 (GND), U$10.10 (GND), U$10.12 (GND), U$11.2 (GND), U$14.1 (GND), U$14.4 (GND), U$15.1 (E), U$15.4 (E), U$16.1 (E), U$16.4 (E), X1.GND
IRSEND: LED4.A, R10.2
IR_EDGE_LEFT: U$6.5 (IO5), U$12.P$6 (6); also elsewhere on the board
IR_EDGE_RIGHT: U$6.15 (IO2), U$12.P$2 (2); also elsewhere on the board
IR_LINE_CENTER: U$6.13 (IO0), U$12.P$4 (4); also elsewhere on the board
IR_LINE_LEFT: U$6.12 (IO3), U$12.P$5 (5); also elsewhere on the board
IR_LINE_RIGHT: U$6.14 (IO1), U$12.P$3 (3); also elsewhere on the board
IR_SWITCH: IC2.3 (QD), Q5.1 (G)
LED-A: JP2.10, R15.2
LIGHT_CENTER: R12.1, U$6.2 (IO6), U$13.2 (E)
LIGHT_LEFT: R11.1, U$3.2 (E), U$6.1 (IO4)
LIGHT_RIGHT: R13.1, U$4.2 (E), U$6.4 (IO7)
MISO: ISP.1 (MISO), JP5.16, U2.11 (PB3(PDO/MISO))
MOSI: IC1.14 (SER), ISP.4 (MOSI), JP2.4, JP5.13, U2.10 (PB2(PDI/MISO))
unnamed: LED2.A, R5.2
unnamed: JP7.P$2 (2), U$7.3 (C)
unnamed: R2.1, X1.D-
unnamed: R1.1, X1.D+
unnamed: Q1.3 (D), Q7.1 (G), R7.1
unnamed: JP6.P$5 (5), U$2.6 (C)
unnamed: Q1.1 (G), S2.2
unnamed: C3.1, C5.1, D2.P$2 (A), U$5.3 (OUT)
unnamed: JP6.P$4 (4), U$2.3 (C)
unnamed: JP6.P$3 (3), U$1.6 (C)
unnamed: IC1.12 (RCK), IC2.12 (RCK), U2.22 (PD5(XCK/CTS))
unnamed: JP8.P$4 (4), U$16.3 (C)
unnamed: JP8.P$3 (3), U$15.6 (C)
unnamed: JP8.P$2 (2), U$15.3 (C)
unnamed: IC1.9 (QH*), IC2.14 (SER)
unnamed: LED4.C, Q6.3 (D)
unnamed: LED1.A, R14.2
unnamed: C7.1, U1.8 (SETP)
unnamed: JP6.P$2 (2), U$1.3 (C)
unnamed: JP3.4, Q3.3 (D)
unnamed: R3.2, S2.1 (O)
unnamed: JP4.1, Q4.2 (S)
unnamed: C7.2, U1.12 (SETC)
unnamed: C17.1, U1.10 (C1)
unnamed: C8.1, U2.42 (AREF)
unnamed: JP7.P$5 (5), U$8.6 (C)
unnamed: JP7.P$4 (4), U$8.3 (C)
unnamed: JP7.P$3 (3), U$7.6 (C)
unnamed: R14.1, U2.32 (PC7(ICP3/CLK0/OC4A))
unnamed: C10.1, C12.1, JP4.2, JP6.P$1 (1), JP7.P$1 (1), JP8.P$1 (1), Q4.1 (G), Q7.3 (D), R10.1, R18.1, U$5.1 (IN)
unnamed: LED3.4 (BLUE_C), LED3.5 (RED_C), LED3.6 (GREEN_C), R30.1
unnamed: JP8.P$5 (5), U$16.6 (C)
PB0: JP2.8, U2.8 (PB0(SS))
PB4: JP5.15, U2.28 (PB4(ADC11))
PB5: JP4.3, U2.29 (PB5(OC1A/OC4B/ADC12))
PB6: JP3.2, R18.2, R19.1, U2.30 (PB6(OC1B/OC4B/ADC13))
PB7: B1.+ (1), U2.12 (PB7(OC0A/OC1C/RTS))
PC6: JP3.3, U2.31 (PC6(OC1A))
PD0: JP5.3, R8.1, R23.2, U1.1 (SCL), U2.18 (PD0(INT0/OC0B)), U$10.4 (SCL)
PD1: JP5.1, R9.1, R24.2, U1.16 (SDA), U2.19 (PD1(INT1/SDA)), U$10.6 (SDA)
PD4: JP2.6, U2.25 (PD4(ICP1/ADC8))
PD6: JP2.7, U2.26 (PD6(T1/OC4D/ADC9))
PD7: Q6.1 (G), U2.27 (PD7(OC4D/ADC10/T0))
PE2: R6.2, U2.33 (PE2(HWB))
PE6: U2.1 (PE6), U$14.3 (OUT)
PF0: U2.41 (PF0(ADC0)), U$6.9 (C)
PF1: U2.40 (PF1(ADC1)), U$6.10 (B)
PF4: U2.39 (PF4(ADC4/TCK)), U$6.11 (A)
PF5: U2.38 (PF5(ADC5/TMS)), U$6.3 (IO)
PF6: JP5.11, U2.37 (PF6(ADC6/TDO))
PF7: JP5.12, U2.36 (PF7(ADC7(TDI))
RGB_B: IC2.2 (QC), LED3.3 (BLUE_A)
RGB_G: IC2.1 (QB), LED3.1 (GREEN_A)
RGB_R: IC2.15 (QA), LED3.2 (RED_A)
RST: C16.1, ISP.5 (RST), R4.1, S1.3, S1.4, U2.13 (/RESET)
RX: JP5.4, U2.20 (PD2(INT2/RXD1))
SCK: IC1.11 (SCK), IC2.11 (SCK), ISP.3 (SCK), JP2.5, JP5.14, U2.9 (PB1(SCK))
SENSE_GND: Q5.3 (D), U$12.P$7 (7); also elsewhere on the board
STEP_1_1: IC1.3 (QD), U$1.5 (B)
STEP_1_2: IC1.2 (QC), U$1.2 (B)
STEP_1_3: IC1.1 (QB), U$2.5 (B)
STEP_1_4: IC1.15 (QA), U$2.2 (B)
STEP_2_1: IC1.7 (QH), U$7.5 (B)
STEP_2_2: IC1.6 (QG), U$7.2 (B)
STEP_2_3: IC1.5 (QF), U$8.5 (B)
STEP_2_4: IC1.4 (QE), U$8.2 (B)
STEP_3_1: IC2.7 (QH), U$15.5 (B)
STEP_3_2: IC2.6 (QG), U$15.2 (B)
STEP_3_3: IC2.5 (QF), U$16.5 (B)
STEP_3_4: IC2.4 (QE), U$16.2 (B)
TX: JP5.2, U2.21 (PD3(INT3/TXD1))
UCAP: C1.1, U2.6 (UCAP)
VBUS: F1.1, U2.7 (VBUS), X1.VBUS
VCC: D1.P$1 (C), D2.P$1 (C), IC1.10 (SCL), IC1.16 (VCC), IC2.10 (SCL), IC2.16 (VCC), ISP.2 (VCC), JP3.1, JP5.7, JP5.8, Q3.1 (G), R4.2, R5.1, R15.1, U2.2 (UVCC), U2.14 (VCC), U2.24 (AVCC), U2.34 (VCC1), U2.44 (AVCC1), U$3.1 (C), U$4.1 (C), U$6.16 (VDD), U$11.1 (IN), U$11.3 (EN), U$12.P$1 (1), U$13.1 (C), U$14.2 (VCC); also elsewhere on the board
VCC_3V3: C2.1, C9.1, C11.1, C14.1, C15.1, JP2.3, JP5.9, R8.2, R9.2, R23.1, R24.1, U1.2 (VDD), U1.4 (S1), U1.13 (VDDIO), U$10.1 (VDDIO), U$10.7 (SA0), U$10.9 (INT2), U$10.11 (INT1), U$10.14 (VDD), U$11.5 (OUT)
V_BATT: JP1.2 (1), Q7.2 (S), R3.1, R7.2
V_USB: D1.P$2 (A), F1.2
XTAL1: C4.1, U2.17 (XTAL1), X2.P$2
XTAL2: C6.1, U2.16 (XTAL2), X2.P$1
ZK_CS: JP2.2
ZK_SO: JP2.1

Notes on the sheet:
LED-A
GND
LCD_CS
LCD_RST
LCD_A0
LCD_CLK
LCD_SI
ZK_CS
ZK_SO
CSN
IRQ
Battery Voltage Monitor
Buzzer
Servo
Ultrasonic
Right Wheel Motor
Gripper Motor
Left Wheel Motor
Expansion Breakout
IR Receiver
IR Send
RGB LED

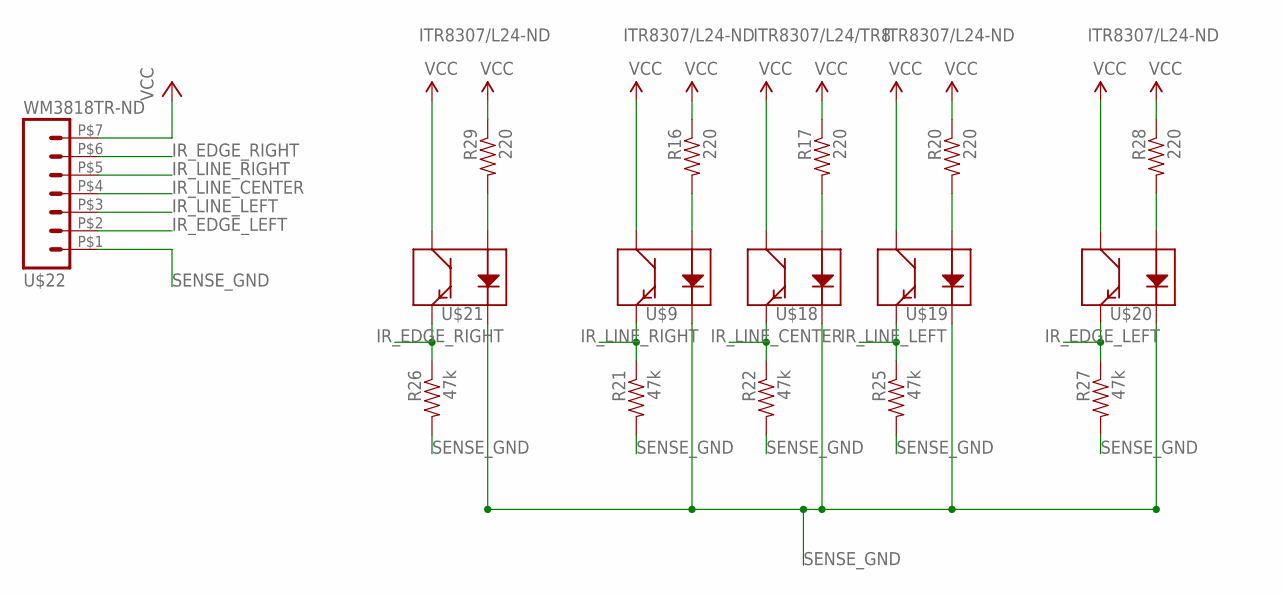
[picture p34: schematic Sparki_Rev15.sch, sheet 2]

Parts:
R16, R17, R20, R28, R29: 220; 0603-RES
R21, R22, R25, R26, R27: 47k; 0603-RES
U$9, U$19, U$20, U$21: ITR8307/L24-ND; QRE1113
U$18: ITR8307/L24/TR8; QRE1113
U$22: WM3818TR-ND; 1X07-1.0MM-FPC

Connections:
IR_EDGE_LEFT: R27.1, U$20.4 (E), U$22.P$2 (2); also elsewhere on the board
IR_EDGE_RIGHT: R26.1, U$21.4 (E), U$22.P$6 (6); also elsewhere on the board
IR_LINE_CENTER: R22.1, U$18.4 (E), U$22.P$4 (4); also elsewhere on the board
IR_LINE_LEFT: R25.1, U$19.4 (E), U$22.P$3 (3); also elsewhere on the board
IR_LINE_RIGHT: R21.1, U$9.4 (E), U$22.P$5 (5); also elsewhere on the board
LINEFLEDLEFT: R16.2, U$9.1 (A)
LINEFLEDMID: R17.2, U$18.1 (A)
LINEFLEDRIGHT: R20.2, U$19.1 (A)
unnamed: R28.2, U$20.1 (A)
unnamed: R29.2, U$21.1 (A)
SENSE_GND: R21.2, R22.2, R25.2, R26.2, R27.2, U$9.2 (K), U$18.2 (K), U$19.2 (K), U$20.2 (K), U$21.2 (K), U$22.P$1 (1); also elsewhere on the board
VCC: R16.1, R17.1, R20.1, R28.1, R29.1, U$9.3 (C), U$18.3 (C), U$19.3 (C), U$20.3 (C), U$21.3 (C), U$22.P$7 (7); also elsewhere on the board

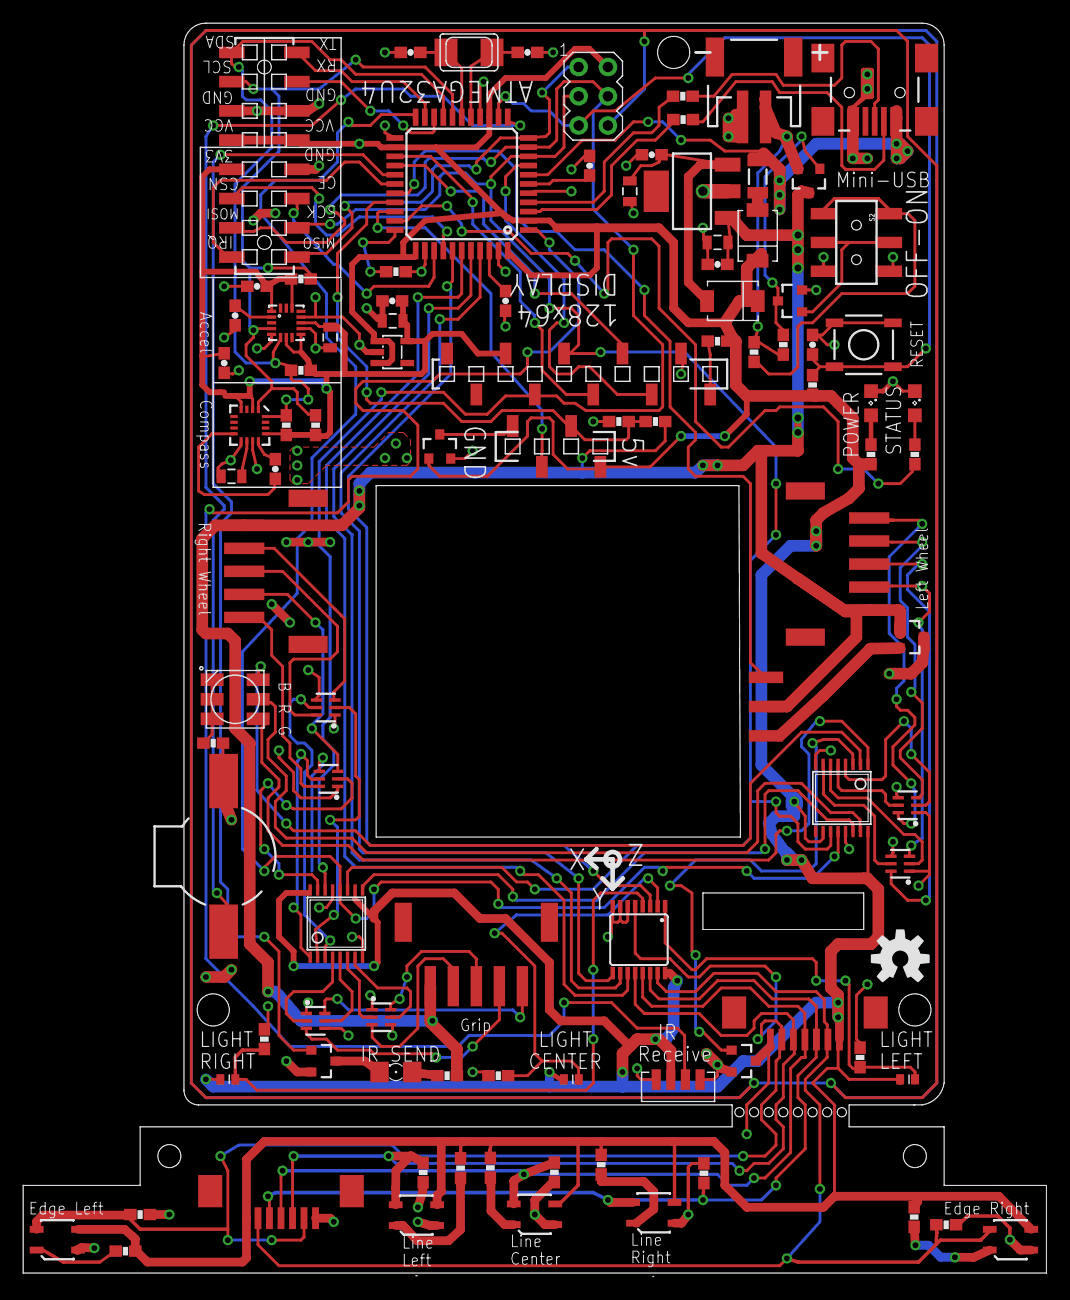
[picture p35: board Sparki_Rev15.brd from above]

Board: 2 copper layers, 88.9 x 108.6 mm, 100 parts (0 on the bottom side), 101 nets.
