ArcBotics/Sparki/Lessons/SparkiDuino/floatingNumbers/floatingNumbers/floatingNumbers.ino

#include <Sparki.h> // include the sparki library

void setup()
{
}

void loop()
{
  sparki.clearLCD(); // erase the LCD

  float foo; // declares a variable of type integer with the name 'foo'

  foo = 10; // assigns the value of 10.0 to foo

  float blerg = 4; // declare a float with the value of 4.0

  sparki.print( "foo: "); 
  sparki.println( foo  );

  sparki.print( "blerg: ");
  sparki.println( blerg ); 

  sparki.print( "foo + blerg: ");
  sparki.println( foo + blerg ); // foo added to blerg

  sparki.print( "foo * blerg: ");
  sparki.println( foo * blerg ); // foo multiplied times blerg

  sparki.print( "foo / blerg: ");
  sparki.println( foo / blerg ); // foo divided by blerg

  sparki.updateLCD(); // put what has been drawn onto the screen
  delay(1000); // wait 1 seconds (1000 milliseconds)
}
