ArcBotics/Sparki/Lessons/SparkiDuino/lightAvoidFollow/lightAvoid/lightAvoid.ino

#include <Sparki.h> // include the sparki library

void setup() 
{
}

void loop() {
  int left   = sparki.lightLeft();   // measure the left light sensor
  int center = sparki.lightCenter(); // measure the center light sensor
  int right  = sparki.lightRight();  // measure the right light sensor

  if ( (center > left) && (center > right) ){  // if the center light is the strongest
    sparki.moveBackward();
  }

  if ( (left > center) && (left > right) ){    // if the left light is the strongest
    sparki.moveRight();
  }

  if ( (right > center) && (right > left) ){   // if the right light is the strongest
    sparki.moveLeft();
  }

  delay(100); // wait 0.1 seconds
}
