ArcBotics/Sparki/Arduino Library/Sparki.cpp

#include "Sparki.h"
#include <inttypes.h>
#include <stdio.h>
#include <string.h>
#include <limits.h>
#include <Arduino.h>

#include <avr/pgmspace.h>
#include <util/delay.h>
#include <stdlib.h>
#include <SPI.h>


#ifndef NO_ACCEL
#include "Sparkii2c.h"
// shares the values of the accelerometers
volatile float xAxisAccel;
volatile float yAxisAccel;
volatile float zAxisAccel;
#endif

#ifndef NO_MAG
#include "SparkiWire.h"
// variables for the magnetometer
volatile uint8_t mag_buffer[RawMagDataLength];
#endif

#include "SparkiEEPROM.h"

static int8_t step_dir[3];                 // -1 = ccw, 1 = cw  

static uint8_t motor_speed[3];              // stores last set motor speed (0-100%)

uint8_t pixel_color = WHITE;

uint8_t ir_active = 1;

uint8_t lcd_initialized = 0; // keeps track of whether LCD buffer has been loaded into memory or not

uint8_t LCD_TYPE = 0; // 0=small, 1=large

static volatile uint8_t move_speed = 100;
static volatile uint8_t speed_index[3];
static volatile uint8_t speed_array[3][SPEED_ARRAY_LENGTH];    
                                        // for each motor, how many 200uS waits between each step. 
                                        // Cycles through an array of 10 of these counts to average 
                                        // for better speed control

static volatile int8_t step_index[3];       // index into _steps array  
static uint8_t _steps_right[9];                   // bytes defining stepper coil activations
static uint8_t _steps_left[9];                   // bytes defining stepper coil activations
static volatile uint32_t remainingSteps[3]; // number of steps before stopping motor
static volatile uint32_t isRunning[3];      // tells if motor is running

static volatile int speedCounter[3];      // variable used in maintaing speed
static volatile int speedCount[3];      // what speedCount is set at when speed cycle resets

static volatile uint8_t shift_outputs[3];      // tells if motor is running

// initialize the RGB timer variables
static volatile uint8_t RGB_vals[3];
static volatile uint16_t RGB_timer;

static volatile uint8_t irSwitch;
static volatile uint8_t irSwitch2;

// variables for communication between the IR read function and its interrupt
#define MAX_IR_PULSE 20000
volatile long timeSinceLastPulse = 0;
volatile long lastPulseTime = 0;
volatile uint16_t pulsesIR[50][2]; // LOW,HIGH
volatile uint8_t currentPulse = 0;
volatile uint8_t haltIRRead = 0;


// values for the servo
volatile int8_t servo_deg_offset = 0;

SparkiClass sparki;

SparkiClass::SparkiClass()
{
 begin();
}

void SparkiClass::begin( ) {
 
  Serial.begin(9600);
  Serial1.begin(9600);

  // set up the Status LED
  pinMode(STATUS_LED, OUTPUT);
  digitalWrite(STATUS_LED, LOW);

  // Setup Buzzer
  pinMode(BUZZER, OUTPUT);
  digitalWrite(BUZZER, LOW);
  
  // Setup Analog Multiplexer
  pinMode(MUX_ANALOG, INPUT);
  pinMode(MUX_A, OUTPUT);
  pinMode(MUX_B, OUTPUT);
  pinMode(MUX_C, OUTPUT);
  
  // Setup IR Send
  pinMode(IR_SEND, OUTPUT);
  
  // Setup Ultrasonic
  pinMode(ULTRASONIC_TRIG, OUTPUT);
  pinMode(ULTRASONIC_ECHO, INPUT);
  
  // Setup Servo
  pinMode(SERVO, OUTPUT);    
  //startServoTimer();
  if( EEPROM.read(0) > 127) {
    servo_deg_offset = -256+EEPROM.read(0);
  }
  else{
    servo_deg_offset = EEPROM.read(0);
  }
  
  if( EEPROM.read(1) == 88) {
    LCD_TYPE = 1; // large LCD
  }
  else{
    LCD_TYPE = 0; // small LCD
  }
  
  // keep offset from going too off if EEPROM corrupted
  if (servo_deg_offset > MAX_SERVO_OFFSET){
    servo_deg_offset = 0;
  }
  if (servo_deg_offset < -MAX_SERVO_OFFSET){
    servo_deg_offset = 0;
  }
  
  //servo(SERVO_CENTER);
    
  
  // Setup the SPI bus for the shift register
  // !!! Need to remove the essential functions from the SPI Library, 
  // !!! and include in the main code
  SPI.begin(); 
  SPI.setClockDivider(SPI_CLOCK_DIV2); 

  // Set the shift-register clock select pin to output 
  DDRD |= (1<<5);
  
  // Clear out the shift registers
  PORTD &= 0xDF;    // pull PD5 low
  SPI.transfer(shift_outputs[1]);
  SPI.transfer(shift_outputs[0]);
  PORTD |= 0x20;    // pull PD5 high to latch in spi transfers


  // Setup the IR Switch
  irSwitch = 0;

  // defining steps for the stepper motors
  _steps_left[0] = 0x10;
  _steps_left[1] = 0x30;
  _steps_left[2] = 0x20;
  _steps_left[3] = 0x60;
  _steps_left[4] = 0x40;
  _steps_left[5] = 0xC0;
  _steps_left[6] = 0x80;
  _steps_left[7] = 0x90;
  _steps_left[8]  = 0x00;

  _steps_right[0] = 0x01;
  _steps_right[1] = 0x03;
  _steps_right[2] = 0x02;
  _steps_right[3] = 0x06;
  _steps_right[4] = 0x04;
  _steps_right[5] = 0x0C;
  _steps_right[6] = 0x08;
  _steps_right[7] = 0x09;
  _steps_right[8] = 0x00;

  #ifdef NOLCD
  progmem_lcd_logo();
  #else
  beginDisplay();
  updateLCD();
  #endif
  
 

  // Setup initial Stepper settings
  motor_speed[MOTOR_LEFT] = motor_speed[MOTOR_RIGHT] = motor_speed[MOTOR_GRIPPER] = move_speed;
  
  // Set up the scheduler routine to run every 200uS, based off Timer4 interrupt
  cli();          // disable all interrupts
  TCCR4A = 0;
  TCCR4B = 0;
  TCNT4  = 0;

  OCR4A = 48;               // compare match register 64MHz/2048 = 31250hz
  //TCCR4B |= (1 << WGM12);   // CTC mode
  TCCR4B = 0x06;
  //TCCR4B = _BV(CS43) | _BV(CS42);            // CLK/2048 prescaler
  TIMSK4 |= (1 << OCIE4A);  // enable Timer4 compare interrupt A
  sei();             // enable all interrupts
  
  // Setup the IR Remote Control pin and pin interrupt
  noInterrupts();
  pinMode(IR_RECEIVE, INPUT);
  
  // Setup the pin interrupt for INT6 (Pin 7) to trigger the IR function
  EICRB = (EICRB & ~((1 << ISC60) | (1 << ISC61))) | (CHANGE << ISC60);
  EIMSK |= (1 << INT6); 
  
  interrupts();
  i2cInit(); // start up i2c for the accelerometer and magnetometer
  #ifndef NO_ACCEL
  initAccelerometer();
  #endif
  
  #ifndef NO_MAG
  WireWrite(ConfigurationRegisterB, (0x01 << 5));
  WireWrite(ModeRegister, Measurement_Continuous);  
  readMag(); // warm it up  
  #endif

}

float SparkiClass::systemVoltage(){
    float voltage=0;
    
    pinMode(BATTERY_MONITOR, INPUT);
    for(uint8_t i=0; i<10; i++){
        voltage += analogRead(10);
        delay(1);
    }
    pinMode(BATTERY_MONITOR, OUTPUT);
    
    voltage = voltage/10.0;
    voltage = voltage*0.00868; // convert reading to voltage

    return voltage;
}

void SparkiClass::setMux(uint8_t A, uint8_t B, uint8_t C){
	digitalWrite(MUX_A, A);
	digitalWrite(MUX_B, B);
	digitalWrite(MUX_C, C);
	delay(1);
}

/* 
* Light Sensors
*/

int SparkiClass::lightRight(){
	setMux(LIGHT_RIGHT);
	return analogRead(MUX_ANALOG);
}

int SparkiClass::lightCenter(){
	setMux(LIGHT_CENTER);
	return analogRead(MUX_ANALOG);
}

int SparkiClass::lightLeft(){
	setMux(LIGHT_LEFT);
	return analogRead(MUX_ANALOG);
}

/*
* Infrared line sensors
*/


int SparkiClass::edgeRight(){
	setMux(IR_EDGE_RIGHT);
    return readSensorIR(MUX_ANALOG);
}

int SparkiClass::lineRight(){
	setMux(IR_LINE_RIGHT);
    return readSensorIR(MUX_ANALOG);
}

int SparkiClass::lineCenter(){
	setMux(IR_LINE_CENTER);
    return readSensorIR(MUX_ANALOG);
}

int SparkiClass::lineLeft(){
	setMux(IR_LINE_LEFT);
    return readSensorIR(MUX_ANALOG);
}

int SparkiClass::edgeLeft(){
	setMux(IR_EDGE_LEFT);
    return readSensorIR(MUX_ANALOG);
}

int SparkiClass::readSensorIR(int pin){
    int read = 0;
	onIR();
	read = analogRead(pin);
	offIR();
	return read;
}

void SparkiClass::onIR()  // turns off the IR Detection LEDs
{
    irSwitch = 1;
    delay(1); // give time for a scheduler cycle to run
}

void SparkiClass::offIR() // turns off the IR Detection LEDs
{
    irSwitch = 0;
    delay(1); // give time for a scheduler cycle to run
}

int SparkiClass::readBlindSensorIR(int pin0, int pin1, int pin2){
    int read = 0;
    setMux(pin0, pin1, pin2);
    delay(1);
	read = analogRead(MUX_ANALOG);
	delay(1);
	return read;
}

int SparkiClass::diffIR(int pin0, int pin1, int pin2){
    setMux(pin0, pin1, pin2);
    delay(1);
	int readOff = analogRead(MUX_ANALOG);
	delay(10);
	onIR();
	int readOn = analogRead(MUX_ANALOG);
	offIR();
	return readOff-readOn;
}

void SparkiClass::beep(){
    tone(BUZZER, BUZZER_FREQ, 200);
}

void SparkiClass::beep(int freq){
    tone(BUZZER, freq, 200);
}

void SparkiClass::beep(int freq, int time){
    tone(BUZZER, freq, time);
}

void SparkiClass::noBeep(){
    noTone(BUZZER);
}

void SparkiClass::RGB(uint8_t R, uint8_t G, uint8_t B)
{
    if(R > 100){
        R = 100;
    }
    if(G > 100){
        G = 100;
    }
    if(B > 100){
        B = 100;
    }
	RGB_vals[0] = int(R/2.0);
	RGB_vals[1] = int(G/2.0);
	RGB_vals[2] = int(B/2.0);
}

/*
 * motor control (non-blocking, except when moving distances)
 * speed is percent 0-100
*/

void SparkiClass::moveRight(float deg)
{
  unsigned long steps = STEPS_PER_DEGREE*deg;
  if(deg == 0){
      moveRight();
  }
  else{
      if(deg < 0){
        moveLeft(-deg);
      }
      else{
          stepRight(steps);
          while( areMotorsRunning() ){
            delay(1);
          }
      }
  }
}

void SparkiClass::stepRight(unsigned long steps)
{
  motorRotate(MOTOR_LEFT, DIR_CCW, move_speed, steps);
  motorRotate(MOTOR_RIGHT, DIR_CCW, move_speed, steps);
}

void SparkiClass::moveRight()
{
  motorRotate(MOTOR_LEFT, DIR_CCW, move_speed, ULONG_MAX);
  motorRotate(MOTOR_RIGHT, DIR_CCW, move_speed, ULONG_MAX);
}

void SparkiClass::moveLeft(float deg)
{
  unsigned long steps = STEPS_PER_DEGREE*deg;
  if(deg == 0){
      moveLeft();
  }
  else{
      if(deg < 0){
        moveRight(-deg);
      }
      else{
          stepLeft(steps);
          while( areMotorsRunning() ){
            delay(1);
          }
      }
  }
}

void SparkiClass::stepLeft(unsigned long steps)
{
  motorRotate(MOTOR_LEFT,  DIR_CW, move_speed, steps);
  motorRotate(MOTOR_RIGHT, DIR_CW, move_speed, steps);
}

void SparkiClass::moveLeft()
{
  motorRotate(MOTOR_LEFT,  DIR_CW, move_speed, ULONG_MAX);
  motorRotate(MOTOR_RIGHT, DIR_CW, move_speed, ULONG_MAX);
}

void SparkiClass::moveForward(float cm)
{
  unsigned long steps = STEPS_PER_CM*cm;
  if(cm == 0){
      moveForward();
  }
  else{
      if(cm < 0){
        moveBackward(-cm);
      }
      else{
          stepForward(steps);
          while( areMotorsRunning() ){
            delay(1);
          }
      }
  }
}

void SparkiClass::stepForward(unsigned long steps)
{
  motorRotate(MOTOR_LEFT, DIR_CCW, move_speed, steps);
  motorRotate(MOTOR_RIGHT, DIR_CW, move_speed, steps);
}

void SparkiClass::moveForward()
{
  motorRotate(MOTOR_LEFT, DIR_CCW, move_speed, ULONG_MAX);
  motorRotate(MOTOR_RIGHT, DIR_CW, move_speed, ULONG_MAX);
}

void SparkiClass::moveBackward(float cm)
{
  unsigned long steps = STEPS_PER_CM*cm;
  if(cm == 0){
      moveBackward();
  }
  else{
      if(cm < 0){
        moveForward(-cm);
      }
      else{
          stepBackward(steps);
          while( areMotorsRunning() ){
            delay(1);
          }
      }
  }
}

void SparkiClass::stepBackward(unsigned long steps)
{
  motorRotate(MOTOR_LEFT,   DIR_CW, move_speed, steps);
  motorRotate(MOTOR_RIGHT, DIR_CCW, move_speed, steps);
}

void SparkiClass::moveBackward()
{
  motorRotate(MOTOR_LEFT,   DIR_CW, move_speed, ULONG_MAX);
  motorRotate(MOTOR_RIGHT, DIR_CCW, move_speed, ULONG_MAX);
}

void SparkiClass::moveStop()
{
  motorStop(MOTOR_LEFT);
  motorStop(MOTOR_RIGHT);
}

void SparkiClass::gripperOpen()
{
  motorRotate(MOTOR_GRIPPER, DIR_CCW, move_speed, ULONG_MAX);
}
void SparkiClass::gripperOpen(float cm)
{
  motorRotate(MOTOR_GRIPPER, DIR_CCW, move_speed, (unsigned long)(cm*STEPS_PER_ARM_CM));
}

void SparkiClass::gripperClose()
{
  motorRotate(MOTOR_GRIPPER, DIR_CW, move_speed, ULONG_MAX);
}
void SparkiClass::gripperClose(float cm)
{
  motorRotate(MOTOR_GRIPPER, DIR_CW, move_speed, (unsigned long)(cm*STEPS_PER_ARM_CM));
}

void SparkiClass::gripperStop()
{
  motorStop(MOTOR_GRIPPER);
}

void SparkiClass::speed(uint8_t speed)
{
    move_speed = speed;
}

void SparkiClass::motorRotate(int motor, int direction, int speed)
{
   motorRotate(motor, direction, speed, ULONG_MAX);
}

void SparkiClass::motorRotate(int motor, int direction, int speed, long steps)
{
   //Serial.print("Motor ");Serial.print(motor); Serial.print(" rotate, dir= "); 
   //Serial.print(direction); Serial.print(", steps= "); Serial.println(steps);
   
   motor_speed[motor] = speed; // speed in 1-100 precent
   
   // populate the speed array with multiples of 200us waits between steps
   // having 10 different waits allows finer grained control
   if(speed == 0){
      uint8_t oldSREG = SREG; cli();
      remainingSteps[motor] = 0; 
      isRunning[motor] = false;
      SREG = oldSREG; sei(); 
   }
   else{
      int base_waits = 500/speed;
      int remainder_waits = int((500.0/float(speed) - float(base_waits))*SPEED_ARRAY_LENGTH); 

      for(uint8_t i=0; i< (SPEED_ARRAY_LENGTH-remainder_waits); i++){
         speed_array[motor][i] = base_waits+1;
       }
      for(uint8_t i=(SPEED_ARRAY_LENGTH-remainder_waits); i<SPEED_ARRAY_LENGTH; i++){
         speed_array[motor][i] = base_waits;
       }
      
      uint8_t oldSREG = SREG; cli();
      speed_index[motor] = 0;
      speedCount[motor] = speed_array[motor][0];
      speedCounter[motor] = speedCount[motor];
      remainingSteps[motor] = steps;
      step_dir[motor] = direction;  
      isRunning[motor] = true;
      SREG = oldSREG; sei(); 

      //Serial.print("base: ");
      //Serial.print(base_waits);
      //Serial.print(", remainder: ");
      //Serial.println(remainder_waits);
   }
   delay(1);
}

void SparkiClass::motorStop(int motor)
{
   motorRotate(motor, 1, 0, 0);
}
 
 // returns true if one or both motors a still stepping
 bool SparkiClass::areMotorsRunning()
 {
   bool result;
   uint8_t oldSREG = SREG;
   cli();
   result =  isRunning[MOTOR_LEFT] || isRunning[MOTOR_RIGHT] || isRunning[MOTOR_GRIPPER] ;
   SREG = oldSREG; 
   sei();
   return result;
 }

int SparkiClass::ping_single(){
  long duration; 
  float cm;
  digitalWrite(ULTRASONIC_TRIG, LOW); 
  delayMicroseconds(2); 
  digitalWrite(ULTRASONIC_TRIG, HIGH); 
  delayMicroseconds(10); 
  digitalWrite(ULTRASONIC_TRIG, LOW); 
  

  uint8_t bit = digitalPinToBitMask(ULTRASONIC_ECHO);
  uint8_t port = digitalPinToPort(ULTRASONIC_ECHO);
  uint8_t stateMask = (HIGH ? bit : 0);
  
  unsigned long startCount = 0;
  unsigned long endCount = 0;
  unsigned long width = 0; // keep initialization out of time critical area
  
  // convert the timeout from microseconds to a number of times through
  // the initial loop; it takes 16 clock cycles per iteration.
  unsigned long numloops = 0;
  unsigned long maxloops = 5000;
	
  // wait for any previous pulse to end
  while ((*portInputRegister(port) & bit) == stateMask)
    if (numloops++ == maxloops)
      return -1;
	
  // wait for the pulse to start
  while ((*portInputRegister(port) & bit) != stateMask)
    if (numloops++ == maxloops)
      return -1;
  
  startCount = micros();
  // wait for the pulse to stop
  while ((*portInputRegister(port) & bit) == stateMask) {
    if (numloops++ == maxloops)
      return -1;
    delayMicroseconds(10); //loop 'jams' without this
    if((micros() - startCount) > 58000 ){ // 58000 = 1000CM
      return -1;
      break;
    }
  }
  duration = micros() - startCount;
  //--------- end pulsein
  cm = (float)duration / 29.0 / 2.0; 
  return int(cm);
}

int SparkiClass::ping(){
  int attempts = 5;
  float distances [attempts];
  for(int i=0; i<attempts; i++){
    distances[i] = ping_single();
    delay(20);
  }
  
  // sort them in order
  int i, j;
  float temp;
 
  for (i = (attempts - 1); i > 0; i--)
  {
    for (j = 1; j <= i; j++)
    {
      if (distances[j-1] > distances[j])
      {
        temp = distances[j-1];
        distances[j-1] = distances[j];
        distances[j] = temp;
      }
    }
  }
  
  // return the middle entry
  return int(distances[(int)ceil((float)attempts/2.0)]); 
}

// Uses timer3 to send on/off IR pulses according to the NEC IR transmission standard
// http://wiki.altium.com/display/ADOH/NEC+Infrared+Transmission+Protocol
// protocol. Turns off timer3 functions and timer4 motor/LED interference to avoid conflict
void SparkiClass::sendIR(uint8_t code){
  char oldSREG = SREG;				
  noInterrupts();  // Disable interrupts for 16 bit register access
  
  //***********************************************
  // Set up and tear down Timer3 and Timer4 roles
  //***********************************************
  
  // saves settings for timer3
  uint8_t TIMSK3_store = TIMSK3;
  uint8_t TCCR3A_store = TCCR3A;
  uint8_t TCCR3B_store = TCCR3B;
  uint8_t TCNT3_store = TCNT3;  
  uint8_t EIMSK_store = EIMSK;
  
  uint8_t TIMSK4_store = TIMSK4;
  
  // wipe the timer settings
  TIMSK4 = 0;
  TIMSK3 = 0;
  TCCR3A = 0;
  TCCR3B = 0;
  TCNT3  = 0;
  EIMSK  = 0;

  TCCR3B |= _BV(CS31);      // set timer clock at 1/8th of CLK_i/o (=CLK_sys)
  OCR3B = 22;               // compare match register
  
  TIMSK3 |= (1 << OCIE3B);  // enable Timer3 compare interrupt B

  interrupts();  // re-enable interrupts
  SREG = oldSREG;
  
  
  //*****************************************
  // send the pulses 
  //*****************************************
  
  
  // leadings 9ms pulse, 4.5ms gap
  irPulse(9000,4500);
  
  // 8 bit address
  for(int i=0; i<8; i++){
      irPulse(563,563); // NEC logical 0
  }
 
  // 8 bit address' logical inverse
  for(int i=0; i<8; i++){
      irPulse(563,1687); // NEC logical 1
  }
  
  // 8 bit command
  for(uint8_t i=0; i<8; i++){
    if( (code & (1<<i)) > 0 ){
        irPulse(563,1687); // NEC logical 1
    }
    else{
        irPulse(563,563);  // NEC logical 0  
    }
  }

  // 8 bit command's logical inverse
  for(uint8_t i=0; i<8; i++){
    if( (code & (1<<i)) > 0 ){
        irPulse(563,563);  // NEC logical 0
    }
    else{
        irPulse(563,1687); // NEC logical 1
    }
  }
  
  // 562.5µs pulse to signal end of transmission
  irPulse(563,10); // NEC logical 1  

  //*****************************************
  // restore Timer3 and Timer4 roles
  //*****************************************
  
  // restore the timer
  TIMSK4 = TIMSK4_store;
  TIMSK3 = TIMSK3_store;
  TCCR3A = TCCR3A_store;
  TCCR3B = TCCR3B_store;
  TCNT3  = TCNT3_store;
  EIMSK  = EIMSK_store;
}

void SparkiClass::irPulse(uint16_t on, uint16_t off){
    TIMSK3 |= (1 << OCIE3B);  // enable  38khz signal
    delayMicroseconds(on);
    TIMSK3 &= ~(1 << OCIE3B);  // disable 38khz signal
    PORTD &= ~(1<<7); // make sure the LED is off
    delayMicroseconds(off);    
}


void SparkiClass::startServoTimer(){
  char oldSREG = SREG;				
  noInterrupts();                                       // Disable interrupts for 16 bit register access
  TCCR1A = 0;                                           // clear control register A 
  TCCR1B = _BV(WGM13);                                  // set mode 8: phase and frequency correct pwm, stop the timer
  ICR1 = 20000;                                         // ICR1 is TOP in p & f correct pwm mode
  TCCR1B &= ~(_BV(CS10) | _BV(CS11) | _BV(CS12));
  TCCR1B |= 0x02;                                       // reset clock select register, and starts the clock
  DDRB |= _BV(PORTB1);                                  // sets data direction register for pwm output pin
  TCCR1A |= _BV(COM1A1);                                // activates the output pin
  interrupts();                                         // re-enable interrupts
  SREG = oldSREG;
}

void SparkiClass::servo(int deg)
{ 
  startServoTimer();
  int duty = int((((float(-deg+servo_deg_offset)*2000/180)+1500)/20000)*1024); // compute the duty cycle for the servo
  //0 = 26
  //180 = 128
  
  unsigned long dutyCycle = 20000;
  dutyCycle *= duty;
  dutyCycle >>= 10;
   
  char oldSREG = SREG;
  noInterrupts();
  OCR1A = dutyCycle;
  
  SREG = oldSREG;
  interrupts();
}

/*
Returns the current IR Code. 
Uses the interrupt on INT6 (PE6, Pin 7) to do the signal reading
If there is no code waiting, pass -1 back immediately.
If there is a code, but its still reading, wait it out then return code
Wipes the current stored code once read.

NEC IR code details here:
http://wiki.altium.com/display/ADOH/NEC+Infrared+Transmission+Protocol
*/

int SparkiClass::readIR(){
    uint8_t code = 0;
    if(currentPulse != 0){ // check there's a code waiting
        while( micros()-lastPulseTime <= MAX_IR_PULSE){
            delayMicroseconds(MAX_IR_PULSE);
        }; // wait for the reading to time out
        // tell the interrupt to not take any more codes
        haltIRRead = 1;
        
        // decode the signal
        for(int i=0; i<8; i++){
            if(pulsesIR[17+i][1] > 1000){
                code |= (1<<i);
            }
        }
        currentPulse = 0; // 'reset' the current IR pulse reading
        haltIRRead = 0;
        return int(code); // return the decoded value
    }
    else{
        return -1; // no signal found, return -1
    }
}

SIGNAL(INT6_vect) {
  if(haltIRRead != 1){
      long currentTime = micros(); // take the current time
      int pinStatus = PINE & (1 << 6); // read the current status of the IR Pin
      timeSinceLastPulse = currentTime-lastPulseTime;
      
      // Tell if its the start of the reading cycle or not (time since last pulse), starts low
      if( (timeSinceLastPulse >= MAX_IR_PULSE) && (pinStatus == LOW)){
        // if reading new pulse, set up. Wipes out the last pulse
        currentPulse = 0;
      }
      else{
        if(currentPulse < 50){
          // otherwise, read the current code
          if(pinStatus){ //(PE6 high) pulse has risen from the end of a low pulse
            pulsesIR[currentPulse][0] = timeSinceLastPulse;
          }
          else{ //(PE6 low) pulse has fallen from the end of a high pulse
            pulsesIR[currentPulse][1] = timeSinceLastPulse;
            currentPulse++;
          }  
        }
      }    
      lastPulseTime = currentTime;
  }
}

#ifndef NO_MAG
float SparkiClass::readMag(){
  WireRead(DataRegisterBegin, RawMagDataLength);
  xAxisMag = ((mag_buffer[0] << 8) | mag_buffer[1]) * M_SCALE;
  zAxisMag = ((mag_buffer[2] << 8) | mag_buffer[3]) * M_SCALE;
  yAxisMag = ((mag_buffer[4] << 8) | mag_buffer[5]) * M_SCALE;    
}

float SparkiClass::compass(){
  readMag();
  
  float heading = atan2(yAxisMag,xAxisMag);
  
  if(heading < 0)
    heading += 2*PI;
  if(heading > 2*PI)
    heading -= 2*PI;
    
  float headingDegrees = heading * 180/M_PI; 
  return headingDegrees;
}

float SparkiClass::magX(){
    readMag();
    return xAxisMag;
}

float SparkiClass::magY(){
    readMag();
    return yAxisMag;
}

float SparkiClass::magZ(){
    readMag();
    return zAxisMag;
}

void SparkiClass::WireWrite(int address, int data){
  Wire.beginTransmission(HMC5883L_Address);
  Wire.write(address);
  Wire.write(data);
  Wire.endTransmission();
}

uint8_t* SparkiClass::WireRead(int address, int length){
  Wire.beginTransmission(HMC5883L_Address);
  Wire.write(DataRegisterBegin);
  Wire.endTransmission();
  
  Wire.beginTransmission(HMC5883L_Address);
  Wire.requestFrom(HMC5883L_Address, RawMagDataLength);

  if(Wire.available() == RawMagDataLength)
  {
	  for(uint8_t i = 0; i < RawMagDataLength; i++)
	  {
		  mag_buffer[i] = Wire.read();
	  }
  }
  Wire.endTransmission();
}
#endif
 /*
  * private functions
  */
 
 // set the number if steps for the given motor 

ISR(TIMER3_COMPB_vect) // IR send function, operates at ~38khz when active
{
    PORTD ^= (1<<7); // toggle the IR LED pin
    TCNT3=0;
}

/***********************************************************************************
The Scheduler
Every 200uS (5,000 times a second), we update the 2 shift registers used to increase
the amount of outputs the processor has
***********************************************************************************/

static volatile uint8_t shift_old_0 = 0x00;
static volatile uint8_t shift_old_1 = 0x00;

ISR(TIMER4_COMPA_vect)          // interrupt service routine that wraps a user defined function supplied by attachInterrupt
{
//void SparkiClass::scheduler(){ 
    // Clear the timer interrupt counter
    TCNT4=0;
    
    shift_old_0 = shift_outputs[0];
    shift_old_1 = shift_outputs[1];

	// clear the shift register values so we can re-write them
    shift_outputs[0] = 0x00;
    shift_outputs[1] = 0x00;
    
    // Update the RGB leds
    if(RGB_timer < RGB_vals[0]){ // update Red led
		shift_outputs[RGB_SHIFT] |= RGB_R;
    }
    if(RGB_timer < RGB_vals[1]){ // update Green led
		shift_outputs[RGB_SHIFT] |= RGB_G;
    }
    if(RGB_timer < RGB_vals[2]){ // update Blue led
		shift_outputs[RGB_SHIFT] |= RGB_B;
    }
    RGB_timer++;
    if(RGB_timer == 50){
    	RGB_timer = 0;
    }

    // IR Detection Switch
    if(irSwitch == 0){
    	shift_outputs[1] &= 0xF7;
    }
    else{
    	shift_outputs[1] |= 0x08;
    }
    
    //// Motor Control ////
    //   Determine what state the stepper coils are in
	for(byte motor=0; motor<3; motor++){
		if( remainingSteps[motor] > 1 ){ // check if finished stepping   
		    // speedCount determines the stepping frequency
		    // interrupt speed (5khz) divided by speedCounter equals stepping freq
		    // 1khz is the maximum reliable frequency at 5v, so we use 5 as the top speed
		    // 5,000hz/5 = 1000hz = micro-stepping frequency
			if(speedCounter[motor] == 0) { 
				step_index[motor] += step_dir[motor];
				remainingSteps[motor]--;
				speedCounter[motor] = speed_array[motor][speed_index[motor]];
				speed_index[motor]++;
				if(speed_index[motor] >= SPEED_ARRAY_LENGTH){
			      speed_index[motor] = 0;
			    }
			}
			else{
			   speedCounter[motor] = speedCounter[motor]-1;
			}
			
		}
		else {  // if this was the last step
			remainingSteps[motor] = 0;  
			isRunning[motor] = false;
			step_index[motor] = 8;
			speedCounter[motor] = -1;
		}     
		
		//   keep indicies from rolling over or under
		if( step_index[motor] >= 8){
			step_index[motor] = 0;
		}
		else if( step_index[motor] < 0){
			step_index[motor] = 7;
		}
		if(isRunning[motor] == false){
			step_index[motor] = 8;
		}
	}

    shift_outputs[0] |= _steps_right[step_index[MOTOR_RIGHT]];
    shift_outputs[0] |= _steps_left[step_index[MOTOR_GRIPPER]];
    shift_outputs[1] |= _steps_left[step_index[MOTOR_LEFT]];

    if( (shift_old_0 != shift_outputs[0]) || (shift_old_1 != shift_outputs[1]) ){
        //return LCD chip select high
        //digitalWrite(LCD_CS,HIGH); 
        PORTB |= 0x01; 

        //output values to shift registers
        PORTD &= ~(1<<5);    // pull PD5 (shift-register latch) low
        SPI.transfer(shift_outputs[1]);
        SPI.transfer(shift_outputs[0]);
        PORTD |= (1<<5);    // pull PD5 (shift-register latch) high         
    }
}

/***********************************************************************************
Display Library
***********************************************************************************/

#define ST7565_STARTBYTES 1

uint8_t is_reversed = 0;

// a handy reference to where the pages are on the screen
const uint8_t pagemap[] = { 3, 2, 1, 0, 7, 6, 5, 4 };

// a 5x7 font table
const uint8_t font[] PROGMEM = { 
  0x0, 0x0, 0x0, 0x0, 0x0,       // Ascii 0
  0x7C, 0xDA, 0xF2, 0xDA, 0x7C,  //ASC(01)
  0x7C, 0xD6, 0xF2, 0xD6, 0x7C,  //ASC(02)
  0x38, 0x7C, 0x3E, 0x7C, 0x38, 
  0x18, 0x3C, 0x7E, 0x3C, 0x18, 
  0x38, 0xEA, 0xBE, 0xEA, 0x38, 
  0x38, 0x7A, 0xFE, 0x7A, 0x38, 
  0x0, 0x18, 0x3C, 0x18, 0x0, 
  0xFF, 0xE7, 0xC3, 0xE7, 0xFF, 
  0x0, 0x18, 0x24, 0x18, 0x0, 
  0xFF, 0xE7, 0xDB, 0xE7, 0xFF, 
  0xC, 0x12, 0x5C, 0x60, 0x70, 
  0x64, 0x94, 0x9E, 0x94, 0x64, 
  0x2, 0xFE, 0xA0, 0xA0, 0xE0, 
  0x2, 0xFE, 0xA0, 0xA4, 0xFC, 
  0x5A, 0x3C, 0xE7, 0x3C, 0x5A, 
  0xFE, 0x7C, 0x38, 0x38, 0x10, 
  0x10, 0x38, 0x38, 0x7C, 0xFE, 
  0x28, 0x44, 0xFE, 0x44, 0x28, 
  0xFA, 0xFA, 0x0, 0xFA, 0xFA, 
  0x60, 0x90, 0xFE, 0x80, 0xFE, 
  0x0, 0x66, 0x91, 0xA9, 0x56, 
  0x6, 0x6, 0x6, 0x6, 0x6,
  0x29, 0x45, 0xFF, 0x45, 0x29, 
  0x10, 0x20, 0x7E, 0x20, 0x10, 
  0x8, 0x4, 0x7E, 0x4, 0x8, 
  0x10, 0x10, 0x54, 0x38, 0x10, 
  0x10, 0x38, 0x54, 0x10, 0x10, 
  0x78, 0x8, 0x8, 0x8, 0x8, 
  0x30, 0x78, 0x30, 0x78, 0x30, 
  0xC, 0x1C, 0x7C, 0x1C, 0xC, 
  0x60, 0x70, 0x7C, 0x70, 0x60, 
  0x0, 0x0, 0x0, 0x0, 0x0, 
  0x0, 0x0, 0xFA, 0x0, 0x0, 
  0x0, 0xE0, 0x0, 0xE0, 0x0, 
  0x28, 0xFE, 0x28, 0xFE, 0x28, 
  0x24, 0x54, 0xFE, 0x54, 0x48, 
  0xC4, 0xC8, 0x10, 0x26, 0x46, 
  0x6C, 0x92, 0x6A, 0x4, 0xA, 
  0x0, 0x10, 0xE0, 0xC0, 0x0, 
  0x0, 0x38, 0x44, 0x82, 0x0, 
  0x0, 0x82, 0x44, 0x38, 0x0, 
  0x54, 0x38, 0xFE, 0x38, 0x54, 
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
}

void SparkiClass::moveUpLine() {
	ensure_lcd_init();
    memmove(st7565_buffer, st7565_buffer+128, 1024-128);
    memset(st7565_buffer+1024-128,0,128);
    updateBoundingBox(0, 0, LCDWIDTH-1, LCDHEIGHT-1);
}

uint8_t print_char_x = 0;
uint8_t print_line_y = 0;

void SparkiClass::textWrite(const char* buffer, uint16_t len) {
  ensure_lcd_init();
  for (uint16_t i=0;i<len;i++){
    if(buffer[i] == '\n'){
      print_line_y++;
      print_char_x=0;
    }
    else{
        if(buffer[i] != '\r'){
            drawChar(print_char_x, print_line_y, buffer[i]);
            print_char_x += 6; // 6 pixels wide
            if (print_char_x + 6 >= LCDWIDTH) {
              print_char_x = 0;    // ran out of this line
              print_line_y++;
            }
        }
    }

    if (print_line_y >= (LCDHEIGHT/8)) {
      moveUpLine();
      print_line_y--;
    }
  }
}



void SparkiClass::drawString(uint8_t x, uint8_t line, char *c) {
  ensure_lcd_init();
  while (c[0] != 0) {
    drawChar(x, line, c[0]);
    c++;
    x += 6; // 6 pixels wide
    if (x + 6 >= LCDWIDTH) {
      x = 0;    // ran out of this line
      line++;
    }
    if (line >= (LCDHEIGHT/8)) {
      moveUpLine();
      line--;
    }
  }
}

void SparkiClass::drawString_P(uint8_t x, uint8_t line, const char *str) { 
  ensure_lcd_init();
  while (1) {
    char c = pgm_read_byte(str++);
    if (! c)
      return;
    drawChar(x, line, c);
    x += 6; // 6 pixels wide
    if (x + 6 >= LCDWIDTH) {
      x = 0;    // ran out of this line
      line++;
    }
    if (line >= (LCDHEIGHT/8))
      return;        // ran out of space :(
  }
}

void  SparkiClass::drawChar(uint8_t x, uint8_t line, char c) {
  ensure_lcd_init();
  for (uint8_t i =0; i<5; i++ ) {
    st7565_buffer[x + (line*128) ] = pgm_read_byte(font+(c*5)+i);
    x++;
  }

  updateBoundingBox(0, line*8, x+5, line*8 + 8);
}

// bresenham's algorithm - thx wikpedia
void SparkiClass::drawLine(uint8_t x0, uint8_t y0, uint8_t x1, uint8_t y1) {
  ensure_lcd_init();
  uint8_t steep = abs(y1 - y0) > abs(x1 - x0);
  if (steep) {
    swap(x0, y0);
    swap(x1, y1);
  }

  if (x0 > x1) {
    swap(x0, x1);
    swap(y0, y1);
  }

  // much faster to put the test here, since we've already sorted the points
  updateBoundingBox(x0, y0, x1, y1);

  uint8_t dx, dy;
  dx = x1 - x0;
  dy = abs(y1 - y0);

  int8_t err = dx / 2;
  int8_t ystep;

  if (y0 < y1) {
    ystep = 1;
  } else {
    ystep = -1;}

  for (; x0<=x1; x0++) {
    if (steep) {
      my_setpixel(y0, x0, pixel_color);
    } else {
      my_setpixel(x0, y0, pixel_color);
    }
    err -= dy;
    if (err < 0) {
      y0 += ystep;
      err += dx;
    }
  }
}

// filled rectangle
void SparkiClass::drawRectFilled(uint8_t x, uint8_t y, uint8_t w, uint8_t h) {
  ensure_lcd_init();

  // stupidest version - just pixels - but fast with internal buffer!
  for (uint8_t i=x; i<x+w; i++) {
    for (uint8_t j=y; j<y+h; j++) {
      my_setpixel(i, j, pixel_color);
    }
  }

  updateBoundingBox(x, y, x+w, y+h);
}

// draw a rectangle
void SparkiClass::drawRect(uint8_t x, uint8_t y, uint8_t w, uint8_t h) {
  ensure_lcd_init();
  // stupidest version - just pixels - but fast with internal buffer!
  for (uint8_t i=x; i<x+w; i++) {
    my_setpixel(i, y, pixel_color);
    my_setpixel(i, y+h-1, pixel_color);
  }
  for (uint8_t i=y; i<y+h; i++) {
    my_setpixel(x, i, pixel_color);
    my_setpixel(x+w-1, i, pixel_color);
  } 

  updateBoundingBox(x, y, x+w, y+h);
}

// draw a circle outline
void SparkiClass::drawCircle(uint8_t x0, uint8_t y0, uint8_t r) {
  ensure_lcd_init();
  updateBoundingBox(x0-r, y0-r, x0+r, y0+r);

  int8_t f = 1 - r;
  int8_t ddF_x = 1;
  int8_t ddF_y = -2 * r;
  int8_t x = 0;
  int8_t y = r;

  my_setpixel(x0, y0+r, pixel_color);
  my_setpixel(x0, y0-r, pixel_color);
  my_setpixel(x0+r, y0, pixel_color);
  my_setpixel(x0-r, y0, pixel_color);

  while (x<y) {
    if (f >= 0) {
      y--;
      ddF_y += 2;
      f += ddF_y;
    }
    x++;
    ddF_x += 2;
    f += ddF_x;
  
    my_setpixel(x0 + x, y0 + y, pixel_color);
    my_setpixel(x0 - x, y0 + y, pixel_color);
    my_setpixel(x0 + x, y0 - y, pixel_color);
    my_setpixel(x0 - x, y0 - y, pixel_color);
    
    my_setpixel(x0 + y, y0 + x, pixel_color);
    my_setpixel(x0 - y, y0 + x, pixel_color);
    my_setpixel(x0 + y, y0 - x, pixel_color);
    my_setpixel(x0 - y, y0 - x, pixel_color);
    
  }
}

void SparkiClass::drawCircleFilled(uint8_t x0, uint8_t y0, uint8_t r) {
  ensure_lcd_init();
  updateBoundingBox(x0-r, y0-r, x0+r, y0+r);

  int8_t f = 1 - r;
  int8_t ddF_x = 1;
  int8_t ddF_y = -2 * r;
  int8_t x = 0;
  int8_t y = r;

  for (uint8_t i=y0-r; i<=y0+r; i++) {
    my_setpixel(x0, i, pixel_color);
  }

  while (x<y) {
    if (f >= 0) {
      y--;
      ddF_y += 2;
      f += ddF_y;
    }
    x++;
    ddF_x += 2;
    f += ddF_x;
  
    for (uint8_t i=y0-y; i<=y0+y; i++) {
      my_setpixel(x0+x, i, pixel_color);
      my_setpixel(x0-x, i, pixel_color);
    } 
    for (uint8_t i=y0-x; i<=y0+x; i++) {
      my_setpixel(x0+y, i, pixel_color);
      my_setpixel(x0-y, i, pixel_color);
    }    
  }
}

void SparkiClass::my_setpixel(uint8_t x, uint8_t y, uint8_t color) {
  ensure_lcd_init();
  if ((x >= LCDWIDTH) || (y >= LCDHEIGHT))
    return;

  // x is which column
  if (color == WHITE) 
    st7565_buffer[x+ (y/8)*128] |= _BV(7-(y%8));  
  if (color == BLACK)
    st7565_buffer[x+ (y/8)*128] &= ~_BV(7-(y%8)); 
    
}

// the most basic function, set a single pixel
void SparkiClass::drawPixel(uint8_t x, uint8_t y) {
  ensure_lcd_init();
  if ((x >= LCDWIDTH) || (y >= LCDHEIGHT))
    return;

  // x is which column
  if (pixel_color == WHITE) 
    st7565_buffer[x+ (y/8)*128] |= _BV(7-(y%8));  
  if (pixel_color == BLACK)
    st7565_buffer[x+ (y/8)*128] &= ~_BV(7-(y%8)); 

  updateBoundingBox(x,y,x,y);
}


// the most basic function, get a single pixel
uint8_t SparkiClass::readPixel(uint8_t x, uint8_t y) {
  ensure_lcd_init();
  if ((x >= LCDWIDTH) || (y >= LCDHEIGHT))
    return 0;

  return (st7565_buffer[x+ (y/8)*128] >> (7-(y%8))) & 0x1;  
}

uint8_t lcd_init_flag = 0;
void SparkiClass::ensure_lcd_init() {
	#ifdef NOLCD
	if (lcd_init_flag == 0){
		lcd_init_flag = 1;	
		st7565_buffer =(uint8_t*)malloc(1024); 
	    print_char_x = 0;
	    print_line_y = 0;
	    memset(st7565_buffer, 0, 1024);
	    updateBoundingBox(0, 0, LCDWIDTH-1, LCDHEIGHT-1);
		//memset(st7565_buffer, 0, 1024);
		
		
		/* for(int i=0; i<1024; i++){
			st7565_buffer[i] = pgm_read_byte(sparki_logo + i);
		} */
			
		updateLCD();
	}
	#endif
}

void SparkiClass::beginDisplay() {
  startSPI();
  st7565_init();
  st7565_command(CMD_DISPLAY_ON);
  st7565_command(CMD_SET_ALLPTS_NORMAL);
  st7565_set_brightness(0x00);
}

void SparkiClass::progmem_lcd_logo(){
  startSPI();
  st7565_init();
  st7565_command(CMD_DISPLAY_ON);
  st7565_command(CMD_SET_ALLPTS_NORMAL);
  st7565_set_brightness(0x00);
  

  uint8_t col, maxcol, p;

  /*
  Serial.print("Refresh ("); Serial.print(xUpdateMin, DEC); 
  Serial.print(", "); Serial.print(xUpdateMax, DEC);
  Serial.print(","); Serial.print(yUpdateMin, DEC); 
  Serial.print(", "); Serial.print(yUpdateMax, DEC); Serial.println(")");
  */

  for(p = 0; p < 8; p++) {
    /*
      putstring("new page! ");
      uart_putw_dec(p);
      putstring_nl("");
    */
#ifdef enablePartialUpdate
    // check if this page is part of update
    if ( yUpdateMin >= ((p+1)*8) ) {
      continue;   // nope, skip it!
    }
    if (yUpdateMax < p*8) {
      break;
    }
#endif

     st7565_command(CMD_SET_PAGE | pagemap[p]);


#ifdef enablePartialUpdate
    col = xUpdateMin;
    maxcol = xUpdateMax;
#else
    // start at the beginning of the row
    col = 2;
    maxcol = LCDWIDTH-1;
#endif

    st7565_command(CMD_SET_COLUMN_LOWER | ((col+ST7565_STARTBYTES) & 0xF));
    st7565_command(CMD_SET_COLUMN_UPPER | (((col+ST7565_STARTBYTES) >> 4) & 0x0F));
    st7565_command(CMD_RMW);
    
    for(; col <= maxcol; col++) {
      //uart_putw_dec(col);
      //uart_putchar(' ');
	  digitalWrite(LCD_A0, HIGH);
      spiwrite(pgm_read_byte(sparki_logo + (128*p)+col));
    }
  }

#ifdef enablePartialUpdate
  xUpdateMin = LCDWIDTH - 1;
  xUpdateMax = 0;
  yUpdateMin = LCDHEIGHT-1;
  yUpdateMax = 0;
#endif  
  
}


void SparkiClass::startSPI(){
  // Setup all the SPI pins
  pinMode(SCK, OUTPUT);
  pinMode(MOSI, OUTPUT);
  pinMode(SS, OUTPUT);
  
  digitalWrite(SCK, LOW);
  digitalWrite(MOSI, LOW);
  digitalWrite(SS, HIGH);

  // Warning: if the SS pin ever becomes a LOW INPUT then SPI 
  // automatically switches to Slave, so the data direction of 
  // the SS pin MUST be kept as OUTPUT.
  SPCR |= _BV(MSTR);
  SPCR |= _BV(SPE);
  
  // Set SPI as fast as possible
  SPCR = (SPCR & ~SPI_CLOCK_MASK) | (SPI_CLOCK_DIV2 & SPI_CLOCK_MASK);
  SPSR = (SPSR & ~SPI_2XCLOCK_MASK) | ((SPI_CLOCK_DIV2 >> 2) & SPI_2XCLOCK_MASK);
}

void SparkiClass::st7565_init(void) {
  // set pin directions
  pinMode(LCD_A0, OUTPUT);
  pinMode(LCD_RST, OUTPUT);
  pinMode(LCD_CS, OUTPUT);

  // toggle RST low to reset; CS low so it'll listen to us
  digitalWrite(LCD_CS, LOW);
  _delay_ms(100);
  digitalWrite(LCD_RST, LOW);
  _delay_ms(100);
  digitalWrite(LCD_RST, HIGH);

  // LCD bias select
  st7565_command(CMD_SET_BIAS_7);
  // ADC select
  if(LCD_TYPE == 0){ // Small LCD
    st7565_command(CMD_SET_ADC_REVERSE);
  }
  if(LCD_TYPE == 1){ // Large LCD
    st7565_command(CMD_SET_ADC_NORMAL);
  }
  
  // SHL select
  st7565_command(CMD_SET_COM_NORMAL);
  // Initial display line
  st7565_command(CMD_SET_DISP_START_LINE);

  // turn on voltage converter (VC=1, VR=0, VF=0)
  st7565_command(CMD_SET_POWER_CONTROL | 0x4);
  // wait for 50% rising
  _delay_ms(50);

  // turn on voltage regulator (VC=1, VR=1, VF=0)
  st7565_command(CMD_SET_POWER_CONTROL | 0x6);
  // wait >=50ms
  _delay_ms(50);

  // turn on voltage follower (VC=1, VR=1, VF=1)
  st7565_command(CMD_SET_POWER_CONTROL | 0x7);
  // wait
  _delay_ms(10);

  // set lcd operating voltage (regulator resistor, ref voltage resistor)
  if(LCD_TYPE == 0){ // Small LCD
    st7565_command(CMD_SET_RESISTOR_RATIO | 0x6);
  }
  if(LCD_TYPE == 1){ // Large LCD
    st7565_command(CMD_SET_RESISTOR_RATIO | 0x5);
  }

  // initial display line
  // set page address
  // set column address
  // write display data

  // set up a bounding box for screen updates

  updateBoundingBox(0, 0, LCDWIDTH-1, LCDHEIGHT-1);
}

inline void SparkiClass::spiwrite(uint8_t c) {
noInterrupts();
    //  make sure un chip-select the shift registers
    PORTD |= 0x20;
    //  chip-select the LCD
    //digitalWrite(LCD_CS,LOW);
    PORTB &= 0xFE;
    
    SPDR = c; // push the byte to be loaded to the SPI register
    while(!(SPSR & (1<<SPIF))); //wait till the register completes

    //return LCD chip select high
    //digitalWrite(LCD_CS,HIGH);
    PORTB |= 0x01;
interrupts();
}
void SparkiClass::st7565_command(uint8_t c) {
  digitalWrite(LCD_A0, LOW);

  spiwrite(c);
}

void SparkiClass::st7565_data(uint8_t c) {
  digitalWrite(LCD_A0, HIGH);

  spiwrite(c);
}
void SparkiClass::st7565_set_brightness(uint8_t val) {
    st7565_command(CMD_SET_VOLUME_FIRST);
    st7565_command(CMD_SET_VOLUME_SECOND | (val & 0x3f));
}


void SparkiClass::updateLCD(void) {
  ensure_lcd_init();
  uint8_t col, maxcol, p;

  /*
  Serial.print("Refresh ("); Serial.print(xUpdateMin, DEC); 
  Serial.print(", "); Serial.print(xUpdateMax, DEC);
  Serial.print(","); Serial.print(yUpdateMin, DEC); 
  Serial.print(", "); Serial.print(yUpdateMax, DEC); Serial.println(")");
  */

  for(p = 0; p < 8; p++) {
    /*
      putstring("new page! ");
      uart_putw_dec(p);
      putstring_nl("");
    */
#ifdef enablePartialUpdate
    // check if this page is part of update
    if ( yUpdateMin >= ((p+1)*8) ) {
      continue;   // nope, skip it!
    }
    if (yUpdateMax < p*8) {
      break;
    }
#endif

     st7565_command(CMD_SET_PAGE | pagemap[p]);


#ifdef enablePartialUpdate
    col = xUpdateMin;
    maxcol = xUpdateMax;
#else
    // start at the beginning of the row
    col = 2;
    maxcol = LCDWIDTH-1;
#endif

    st7565_command(CMD_SET_COLUMN_LOWER | ((col+ST7565_STARTBYTES) & 0xF));
    st7565_command(CMD_SET_COLUMN_UPPER | (((col+ST7565_STARTBYTES) >> 4) & 0x0F));
    st7565_command(CMD_RMW);
    
    for(; col <= maxcol; col++) {
      //uart_putw_dec(col);
      //uart_putchar(' ');
      st7565_data(st7565_buffer[(128*p)+col]);
    }
  }

#ifdef enablePartialUpdate
  xUpdateMin = LCDWIDTH - 1;
  xUpdateMax = 0;
  yUpdateMin = LCDHEIGHT-1;
  yUpdateMax = 0;
#endif
}

// clear everything
void SparkiClass::clearLCD(void) {
  ensure_lcd_init();
  print_char_x = 0;
  print_line_y = 0;
  memset(st7565_buffer, 0, 1024);
  updateBoundingBox(0, 0, LCDWIDTH-1, LCDHEIGHT-1);
}


// this doesnt touch the buffer, just clears the display RAM - might be handy
void SparkiClass::clear_display(void) {
  uint8_t p, c;
  
  for(p = 0; p < 8; p++) {
    /*
      putstring("new page! ");
      uart_putw_dec(p);
      putstring_nl("");
    */

    st7565_command(CMD_SET_PAGE | p);
    for(c = 0; c < 129; c++) {
      //uart_putw_dec(c);
      //uart_putchar(' ');
      st7565_command(CMD_SET_COLUMN_LOWER | (c & 0xf));
      st7565_command(CMD_SET_COLUMN_UPPER | ((c >> 4) & 0xf));
      st7565_data(0x0);
    }     
  }
}


/***********************************************************************************
Accelerometer Library
***********************************************************************************/
#ifndef NO_ACCEL
void SparkiClass::readAccelData()
{
  int accelCount[3];
  uint8_t rawData[6];  // x/y/z accel register data stored here
  
  
  readi2cRegisters(0x01, 6, &rawData[0], MMA8452_ADDRESS);  // Read the six raw data registers into data array
  

  // Loop to calculate 12-bit ADC and g value for each axis
  for (uint8_t i=0; i<6; i+=2)
  {
    accelCount[i/2] = ((rawData[i] << 8) | rawData[i+1]) >> 4;  // Turn the MSB and LSB into a 12-bit value
    if (rawData[i] > 0x7F)
    {  
      // If the number is negative, we have to make it so manually (no 12-bit data type)
      accelCount[i/2] = ~accelCount[i/2] + 1;
      accelCount[i/2] *= -1;  // Transform into negative 2's complement #
    }
  }
  xAxisAccel = (float) accelCount[0]/((1<<12)/(2*ACCEL_SCALE));
  yAxisAccel = (float) accelCount[1]/((1<<12)/(2*ACCEL_SCALE));
  zAxisAccel = (float) accelCount[2]/((1<<12)/(2*ACCEL_SCALE));
}

int SparkiClass::initAccelerometer()
{
  uint8_t c = readi2cRegister(0x0D, MMA8452_ADDRESS);  // Read WHO_AM_I register
  if (c == 0x2A){ // WHO_AM_I should always be 0x2
    // Must be in standby to change registers, so we do that
    c = readi2cRegister(0x2A, MMA8452_ADDRESS);
    readi2cRegister(0x2A, c & ~(0x01), MMA8452_ADDRESS);
  
    // Set up the full scale range
    readi2cRegister(0x0E, ACCEL_SCALE >> 2, MMA8452_ADDRESS); 
  
    // Setup the 3 data rate bits, from 0 to 7
    readi2cRegister(0x2A, readi2cRegister(0x2A, MMA8452_ADDRESS) & ~(0x38), MMA8452_ADDRESS);
    if (ACCEL_DATARATE <= 7)
      readi2cRegister(0x2A, readi2cRegister(0x2A, MMA8452_ADDRESS) | (ACCEL_DATARATE << 3), MMA8452_ADDRESS);  
  
    // Set back to active mode to start reading
    c = readi2cRegister(0x2A, MMA8452_ADDRESS);
    readi2cRegister(0x2A, c | 0x01, MMA8452_ADDRESS);
    return 1;
  }
  else{
    return -1;
  }
}

float SparkiClass::accelX(){
    readAccelData();
    return -xAxisAccel*9.8;
}
float SparkiClass::accelY(){
    readAccelData();
    return -yAxisAccel*9.8;
}
float SparkiClass::accelZ(){
    readAccelData();
    return -zAxisAccel*9.8;
}

// Read i registers sequentially, starting at address into the dest byte array
void SparkiClass::readi2cRegisters(byte address, int i, byte * dest, uint8_t i2cAddress)
{
  i2cSendStart();
  i2cWaitForComplete();

  i2cSendByte((i2cAddress<<1)); // write 0xB4
  i2cWaitForComplete();

  i2cSendByte(address);	// write register address
  i2cWaitForComplete();

  i2cSendStart();
  i2cSendByte((i2cAddress<<1)|0x01); // write 0xB5
  i2cWaitForComplete();
  for (int j=0; j<i; j++)
  {
    i2cReceiveByte(-1); // -1 = True
    i2cWaitForComplete();
    dest[j] = i2cGetReceivedByte(); // Get MSB result
  }
  i2cWaitForComplete();
  i2cSendStop();

  cbi(TWCR, TWEN); // Disable TWI
  sbi(TWCR, TWEN); // Enable TWI
}

// Read a single byte from address and return it as a byte
byte SparkiClass::readi2cRegister(uint8_t address, uint8_t i2cAddress)
{
  byte data;
  
  i2cSendStart();
  i2cWaitForComplete();
  
  i2cSendByte((i2cAddress<<1)); // Write 0xB4
  i2cWaitForComplete();
  
  i2cSendByte(address);	// Write register address
  i2cWaitForComplete();
  
  i2cSendStart();
  
  i2cSendByte((i2cAddress<<1)|0x01); // Write 0xB5
  i2cWaitForComplete();
  i2cReceiveByte(-1); // -1 = True
  i2cWaitForComplete();
  
  data = i2cGetReceivedByte();	// Get MSB result
  i2cWaitForComplete();
  i2cSendStop();
  
  cbi(TWCR, TWEN);	// Disable TWI
  sbi(TWCR, TWEN);	// Enable TWI
  
  return data;
}

// Writes a single byte (data) into address
void SparkiClass::readi2cRegister(unsigned char address, unsigned char data, uint8_t i2cAddress)
{
  i2cSendStart();
  i2cWaitForComplete();

  i2cSendByte((i2cAddress<<1)); // Write 0xB4
  i2cWaitForComplete();

  i2cSendByte(address);	// Write register address
  i2cWaitForComplete();

  i2cSendByte(data);
  i2cWaitForComplete();

  i2cSendStop();
}
#endif
