ArcBotics/Sparki/Arduino Library/examples/Parts/Gripper/Gripper.ino

/*******************************************
 Basic Gripper test
 
 Sparki has two little grippers it can be 
 used to grab objects and drag them around.
 See what you can grab with them!
 
 http://arcbotics.com/products/sparki/parts/gripper/
********************************************/
#include <Sparki.h> // include the sparki library

void setup()
{
}

void loop()
{
  sparki.gripperOpen();  // open the robot's gripper
  delay(1000);           // for 1 second (1000 milliseconds)
  
  sparki.gripperClose(); // close the robot's gripper
  delay(1000);           // for 1 second (1000 milliseconds)
  
  sparki.gripperStop();  // stop the grippers from moving
  delay(1000);           // for 1 second (1000 milliseconds)

  sparki.gripperOpen(3);  // open the robot's gripper by 3 centimeters
  sparki.gripperClose(3); // close the robot's gripper by 3 centimeters
  delay(1000);           // wait 1 second (1000 milliseconds)
}
