ArcBotics/Sparki/(commit log)

2013-01-31 moved arduino code to seperate folder
2013-01-31 moved arduino library files to seperate folder
2013-05-01 added latest files
    [0.5in Ball Bearing.SLDPRT, 28BYJ48 Stepper Motor.SLDPRT, 2xAA Battery Holder.SLDPRT, 4xAA Battery Holder.SLDASM, AA Battery.SLDPRT, Base.SLDPRT, Base.STL, Board Rev7.SLDPRT]
2013-06-20 Updated connectors, sensor multiplexing
    [Sparki_Mainboard.brd, Sparki_Mainboard.sch, Sparki_Senseboard.brd, Sparki_Senseboard.sch]
2013-06-20 Removed Old Schematics
2013-07-29 Got all examples fixed and working for Rev10
    [Light.ino, Sparki.cpp, Sparki.h, Wheels.ino]
2013-09-03 Fixed improper mux values for IR sensors
    [Sparki.h]
2013-09-03 Updated plastic files to production version
    [Base.SLDPRT, Base.STL, Bottom.IGS, Bottom.STEP, Bottom.STL, Claw Gear.SLDPRT, Claw.SLDPRT, Claw.STL]
2013-09-03 Fixed error where steppers where always on
    [Sparki.cpp]
2013-09-04 updated STLs to production version
    [Gear.STL]
2013-09-22 remove erroneous IR code correction
    [Sparki.cpp]
2013-09-22 Servo functions put on Timer1, jitter eliminated
    [Servo.ino, Sparki.cpp, Sparki.h]
2013-10-12 launch revision electronics
    [Sparki_Mainboard.brd, Sparki_Mainboard.sch, Sparki_Senseboard.brd, Sparki_Senseboard.sch]
2014-02-04 Updated Arduino library and examples to current - 1.0.5.3
    [Sparki_Rev15.brd, Sparki_Rev15.sch]
2014-02-14 Update Hill_Climb.ino
    Corrected typo of moveBackward function.
    [Hill_Climb.ino]
2014-02-15 interrupt clear addition
2014-02-16 Fixed hill climb example sign error
    [Hill_Climb.ino]
2014-02-16 Fixed line following code so it moves forward when line centered
    [Line_Following.ino]
2014-02-16 Added default program with added edge avoidance
    [Restore_Default.ino]
2014-02-16 Corrected remote example to match default code
    [Remote.ino]
2014-02-16 Changed edge avoidance to more reasonable value
    [Edge_Avoidance.ino, Restore_Default.ino]
2014-02-16 2nd though, Removed edge avoidance from default code
    [Restore_Default.ino]
2014-02-17 Fixed definition error causing LCD code not to work
    [Sparki.h]
2014-02-18 Changed error with moveRight code
    [Sparki.cpp]
2014-02-21 Add some `sei` missing after `cli`
    [Sparki.cpp]
2014-02-22 Fixed missing RGB_ from rgb color codes
    [IfStatement.ino]
2014-02-24 Moved magnetometer buffer to global array
2014-02-25 Updated RGB for more/more accurate colors. Used correct cap of 100 in the example.
    [Sparki.cpp, Sparki.h]
2014-02-25 Changed servo min/max to keep servo from hitting LCD as often
2014-03-10 Tightened Servo Limits
2014-05-13 Updated interrupt comment
    Updated comment to reflect true scheduler timing speed
2014-05-14 motion now math and step (vs time) based, changed buzzer to louder freq
    [Sparki.cpp, Sparki.h]
2014-05-16 IR Send function fixed and implemented
    [Sparki.cpp, Sparki.h]
2014-05-16 Removed extraneous twi files, fixed move code
    [Sparki.cpp]
2014-05-16 Turn of IR Receive interrupt when IR Send is transmitting
2014-05-16 Roll twi.c and twi.h into SparkiWire
    Solves weird dependency/inclusion/compilation issues
    [SparkiWire.cpp, SparkiWire.h]
2014-05-24 extraneous delay in wall avoidance example
    [Wall_Avoidance.ino]
2014-07-10 Added "Using the Ultrasonic Distance Sensor" (SparkiDuino) examples.
2014-07-10 Added "Basic Gripper Usage" (SparkiDuino) examples.
2014-07-10 Added "Follow and Avoid Light" (SparkiDuino) examples.
    [lightAvoid.ino, lightFollow.ino]
2014-07-11 Added "Mixing Colors with the RGB LED" (miniBloq) examples.
2014-07-11 Added "Mixing Colors with the RGB LED" (SparkiDuino) examples.
2014-07-17 Added "Accelerometer" example.
2014-07-17 Added "Gripper" example.
2014-07-17 Added "infrared LED" example.
2014-07-17 Added "Infrared Reflective Sensors" example.
2014-07-17 Added "Light Sensor" example.
2014-07-17 Added "Magnetometer" example.
2014-07-17 Added "RGB LED" example.
2014-07-17 Added "Status LED" example.
2014-07-17 Added "Wheels" example.
2014-07-17 Added "Servo" example.
2014-07-17 Ultrasonic" example.
2014-07-17 Ultrasonic Small Distance Test" troubleshooting code snippet.
2014-07-18 Added "switch" code.
2014-07-28 Added NO_MAG,NO_ACCEL,NO_LCD options to save memory Positioning for grippers Fixed LCD Printing Bug Added RGB Examples
    [RGB_Fading.ino, RGB_Rainbow.ino, Sparki.cpp, Sparki.h]
2014-07-29 EEPROM Corruption Check for servo offset
2014-07-30 Added the short loop version of the "Object Retrieval" lesson sketch.
    [objectMover0.ino, objectRetrieval3.ino]
2014-08-01 Added initial code snippets for the "Signal Filtering Techniques" lesson.
2014-08-04 Improved the "Average" example on the "Signal Filtering Techniques" lesson.
2014-08-04 Added the "Generic Average" example on the "Signal Filtering Techniques" lesson.
2014-08-07 Implemented battery voltage monitoring
2014-08-07 Fixed Basic Radio Example
    [Basic_Radio.ino]
2014-08-07 Updated gripper example
2014-08-20 Minor correction to the 3rd example belonging to the "Computer Inputs" lesson.
    [basicControl30.ino]
2014-08-31 Added new example for the "Sparki + Android: Multipl Sensors" lesson.
2014-09-01 Corrected a small typo in the moveTo example from the "Room Navigation" lesson.
    [moveTo.ino]
2014-09-08 Fixed negative movement looping
    [Sparki.cpp]
2014-09-15 Worked on the doors0 example: problems with the error in the ultrasonic ranger.
    [doors0.ino]
2014-09-15 Started to work on the deadReckoningNav0 example: problems with the error in the ultrasonic ranger.
    [deadReckoningNav0.ino]
2014-11-30 Added compatibility function for old motorRotate
2015-05-01 Maze_Completing_01
    Added for new maze solving material
2015-05-14 Rename to basic_code to basics, new arduino req
2015-05-28 New Maze Solving Arduino files
    Arduino files for maze solving (not line following)
    mazeSolver01 - partial
    mazeSolver02 - full
2015-06-09 Fixed Names
    Fixed names to be consistent with previous naming format
    [bluetoothMovement01.ino]
2015-06-11 Bluetooth/movement conflict
    When I add a movement function I start getting very strange things
    happening, serial ports disappear, a println appeared to not copy
    correctly to the Atmega, the code which previously worked (and was not
    changed) no longer functions. Details in email to Joe.
    TLDR- bluetoothMovement02 works fine. bluetoothMovement02FAIL does not.
    It doesn’t even get to the code that was added because somehow the code
    that used to work now doesn’t.
    [bluetoothMovement02FAIL.ino]
2015-06-11 More bluetooth code
    Finishing this up and scaling down scope of lesson to account for
    issues encountered
    [bluetoothMovement03.ino]
2015-06-30 Changed floating numbers sketch
    Changed code so it doesn’t allude to profanity
    [floatingNumbers.ino]
2015-12-11 Updated Library examples to Arduino 1.6 standards
2015-12-13 reverted from testing for large LCD
    [Sparki.cpp]
2016-03-25 Fixed I2C initialization for Accel and Mag
    [Sparki.cpp]
2016-04-29 Fixed bug in pixel color writing - Thanks Jermey!
    [Sparki.cpp]
2016-05-18 fixed LCD update masking error - Thanks Nikolaus Correll!
    [Sparki.cpp]
2016-07-06 Fixed buffer overflow error caused by multiple simultaneous remotes
    [Sparki.cpp]
2018-03-06 Added ArduBlock LCD features, updated to latest version
    Fixed incompatibilities in Ardublock caused by latest version of
    Arduino by updating Ardublock to latest version, added in LCD usage
    while I was at it
